bminch/me_gizmo/PCBs/me_gizmo/WB_Breakout/WB_Breakout.csv

Reference | Qty | Value | DNP | Exclude from BOM | Exclude from Board | Footprint | Datasheet
C1,C2,C3,C4 | 4 | 0.1u |  |  |  | Capacitor_SMD:C_0603_1608Metric | ~
J1 | 1 | Conn_01x08_Pin |  |  |  | Connector_PinHeader_2.54mm:PinHeader_1x08_P2.54mm_Vertical | ~
J2 | 1 | Conn_01x05_Pin |  |  |  | Connector_PinHeader_2.54mm:PinHeader_1x05_P2.54mm_Vertical | ~
J4 | 1 | Conn_01x10_Pin |  |  |  | Connector_PinHeader_2.54mm:PinHeader_1x10_P2.54mm_Vertical | ~
R1,R2,R3 | 3 | 10k |  |  |  | Resistor_SMD:R_0603_1608Metric | ~
R19,R20,R21,R22,R35,R36,R37,R38,R39,R40,R41,R42 | 12 | 118 |  |  |  | Resistor_SMD:R_0603_1608Metric | ~
R23,R24,R25,R26,R27,R28,R29,R30,R31,R32,R33,R34 | 12 | 348 |  |  |  | Resistor_SMD:R_0603_1608Metric | ~
U1,U2,U3,U4 | 4 | ADG714 |  |  |  | Package_SO:TSSOP-24_4.4x7.8mm_P0.65mm | https://www.analog.com/media/en/technical-documentation/data-sheets/ADG714_715.pdf
