bminch/me_gizmo/PCBs/Eclectronics/3dshapes/plug-usbc-241smtv-4bs60_asm.stp

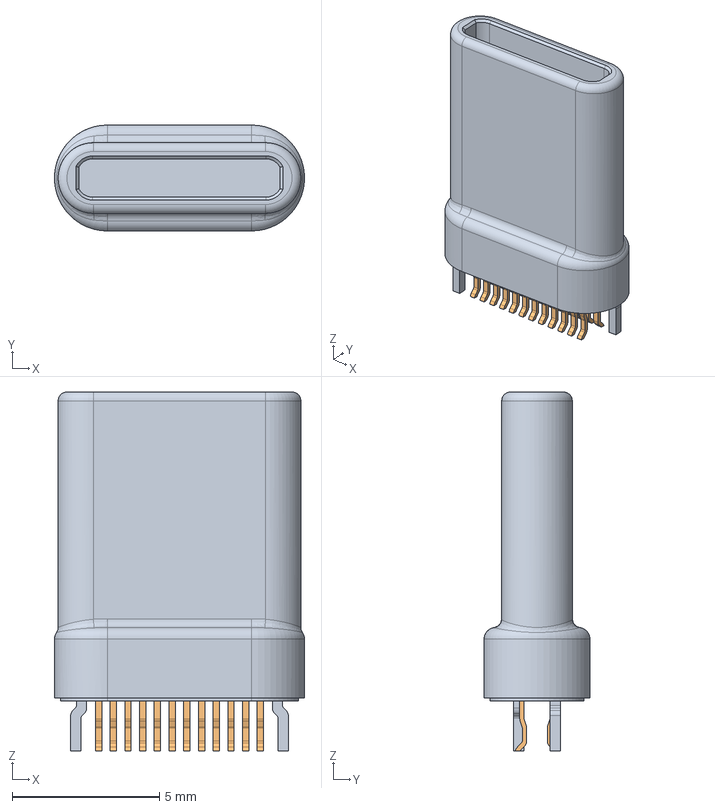
[picture p1: CAD file, 2026-06-01]
PCBs/Eclectronics/3dshapes/plug-usbc-241smtv-4bs60_asm.stp
8.50 x 3.60 x 12.2 mm
PLUG-USBC-241SMTV-4BS60_1
PLUG-USBC-241SMTV-4BS60_2
PLUG-USBC-241SMTV-4BS60_3
PLUG-USBC-241SMTV-4BS60_4
PLUG-USBC-241SMTV-4BS60_5
PLUG-USBC-241SMTV-4BS60_6
PLUG-USBC-241SMTV-4BS60_7
PLUG-USBC-241SMTV-4BS60_8
PLUG-USBC-241SMTV-4BS60_9
PLUG-USBC-241SMTV-4BS60_10
PLUG-USBC-241SMTV-4BS60_11
PLUG-USBC-241SMTV-4BS60_12
PLUG-USBC-241SMTV-4BS60_13
PLUG-USBC-241SMTV-4BS60_14
PLUG-USBC-241SMTV-4BS60_15
PLUG-USBC-241SMTV-4BS60_16
PLUG-USBC-241SMTV-4BS60_17
PLUG-USBC-241SMTV-4BS60_18
PLUG-USBC-241SMTV-4BS60_19
PLUG-USBC-241SMTV-4BS60_20
PLUG-USBC-241SMTV-4BS60_21
PLUG-USBC-241SMTV-4BS60_22
PLUG-USBC-241SMTV-4BS60_23
PLUG-USBC-241SMTV-4BS60_24
PLUG-USBC-241SMTV-4BS60_25
