bminch/me_gizmo/PCBs/Eclectronics/3dshapes/RP2350B.step

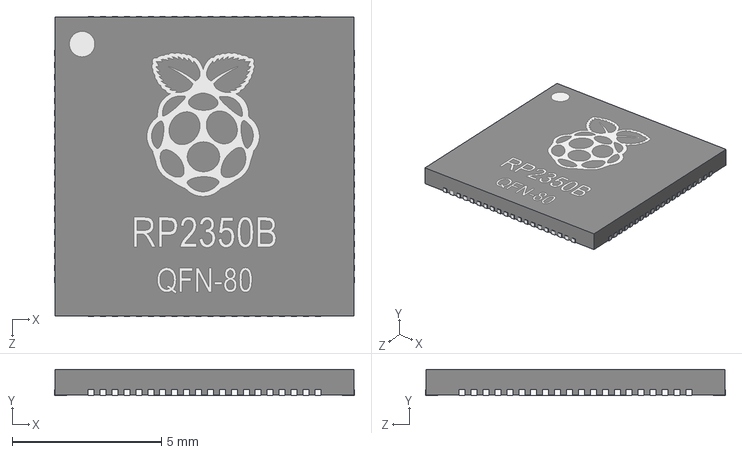
[picture p2: CAD file, 2026-06-11]
PCBs/Eclectronics/3dshapes/RP2350B.step
10.1 x 0.875 x 10.1 mm
