bminch/me_gizmo/PCBs/Eclectronics/3dshapes/DFN1006-2.stp

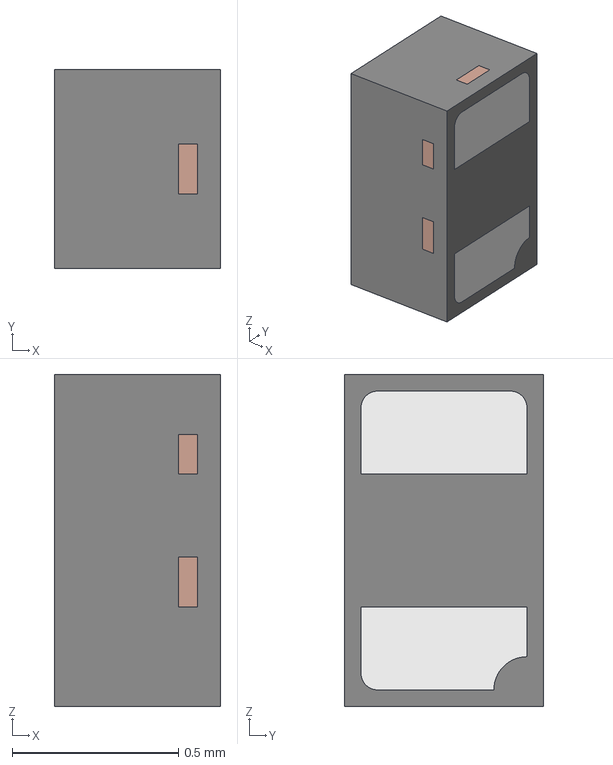
[picture p3: CAD file, 2026-06-01]
PCBs/Eclectronics/3dshapes/DFN1006-2.stp
0.5 x 0.6 x 1.00 mm
LDF
