bminch/me_gizmo/PCBs/Eclectronics/3dshapes/USB4505-03-0-A_REVA.step

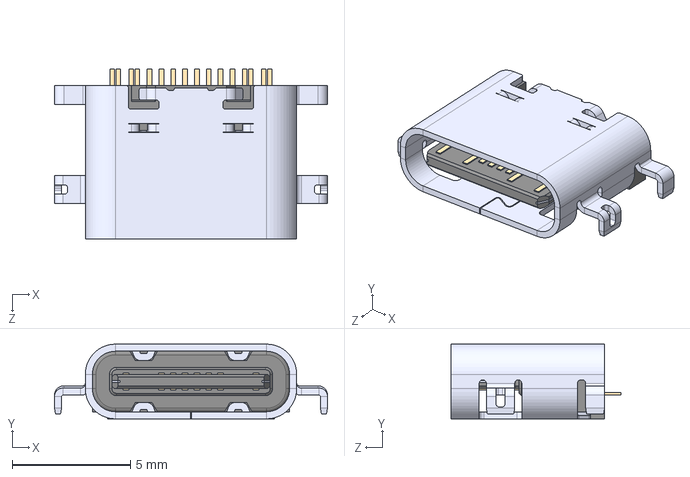
[picture p4: CAD file, 2026-06-01]
PCBs/Eclectronics/3dshapes/USB4505-03-0-A_REVA.step
11.5 x 3.16 x 7.20 mm
