bminch/me_gizmo/PCBs/Eclectronics/3dshapes/WSON8-6x5.STEP

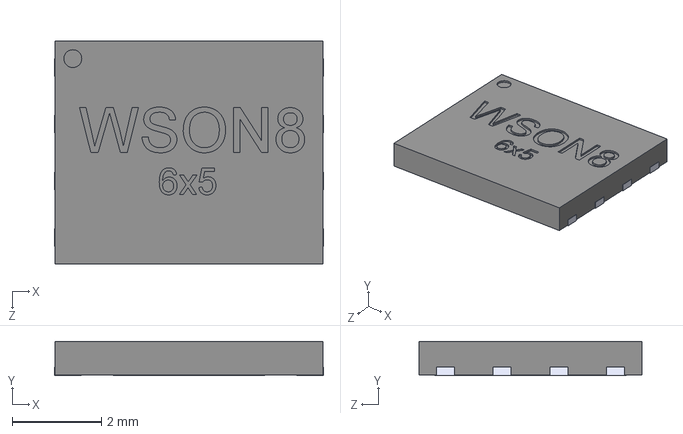
[picture p5: CAD file, 2026-06-01]
PCBs/Eclectronics/3dshapes/WSON8-6x5.STEP
6.02 x 0.77 x 5.00 mm
