bminch/me_gizmo/PCBs/Eclectronics/3dshapes/S4B-PH-SM4-TB.stp

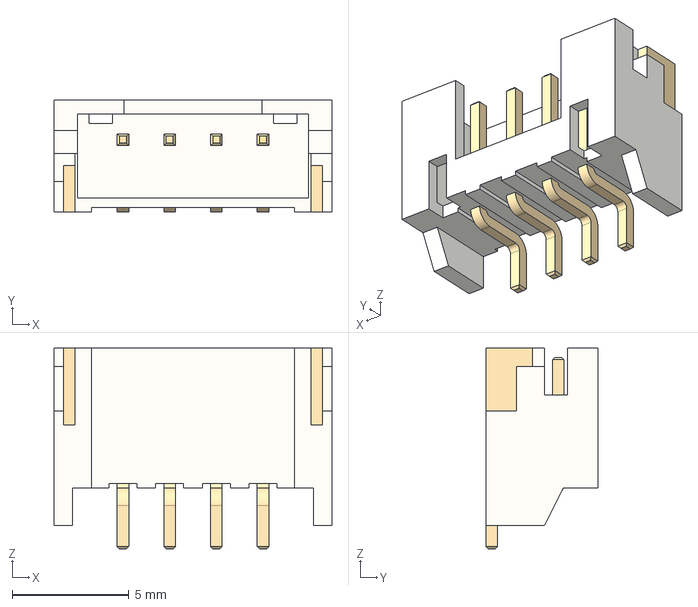
[picture p6: CAD file, 2026-06-01]
PCBs/Eclectronics/3dshapes/S4B-PH-SM4-TB.stp
11.9 x 4.80 x 8.60 mm
