bminch/me_gizmo/PCBs/Eclectronics/3dshapes/CUI_DEVICES_PJ-202A.step

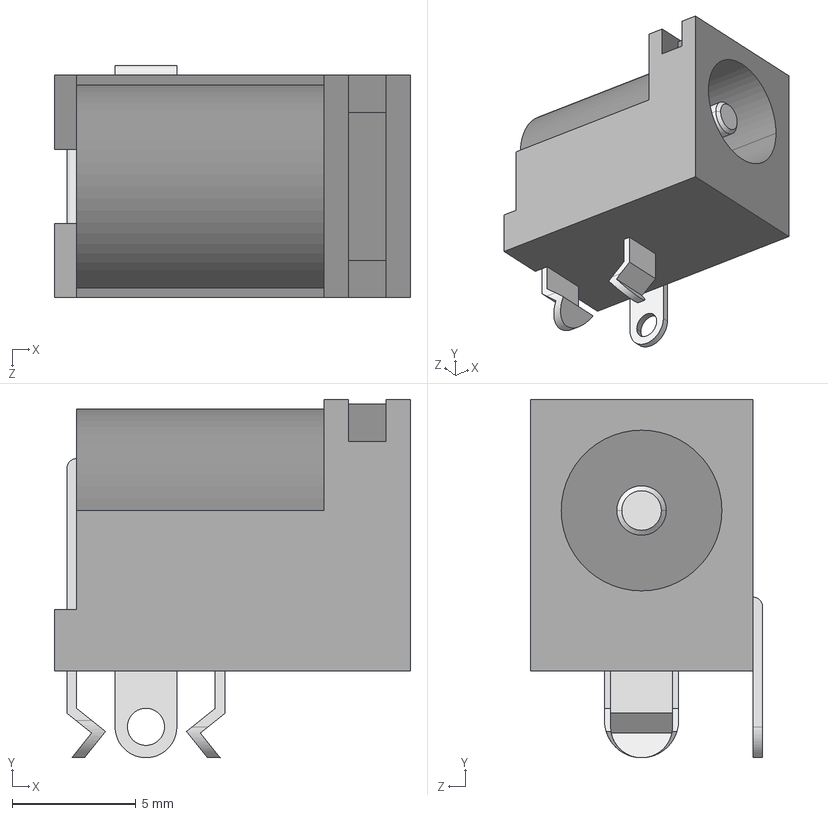
[picture p7: CAD file, 2026-06-01]
PCBs/Eclectronics/3dshapes/CUI_DEVICES_PJ-202A.step
14.4 x 14.5 x 9.40 mm
