bminch/me_gizmo/PCBs/Eclectronics/3dshapes/BarrelJack.STEP

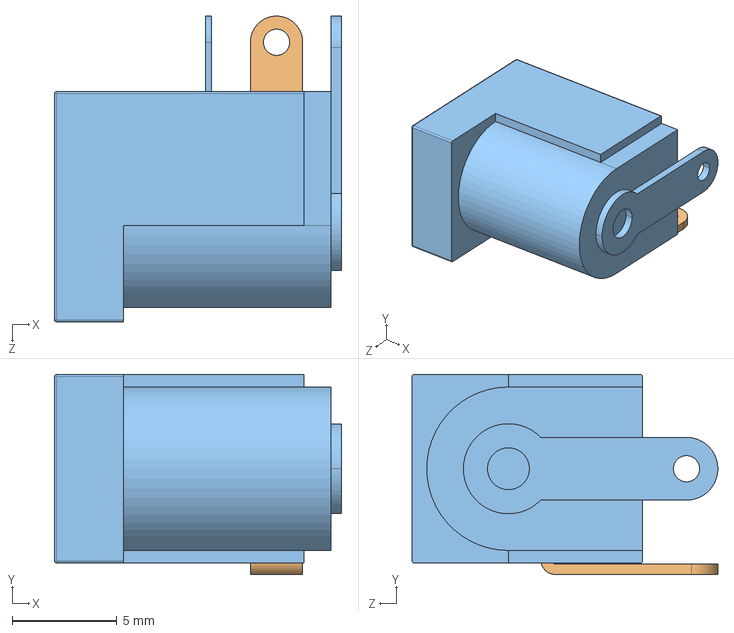
[picture p8: CAD file, 2026-06-01]
PCBs/Eclectronics/3dshapes/BarrelJack.STEP
13.7 x 9.55 x 14.6 mm
