bminch/me_gizmo/PCBs/Eclectronics/3dshapes/TL3301NFxxxxJ.stp

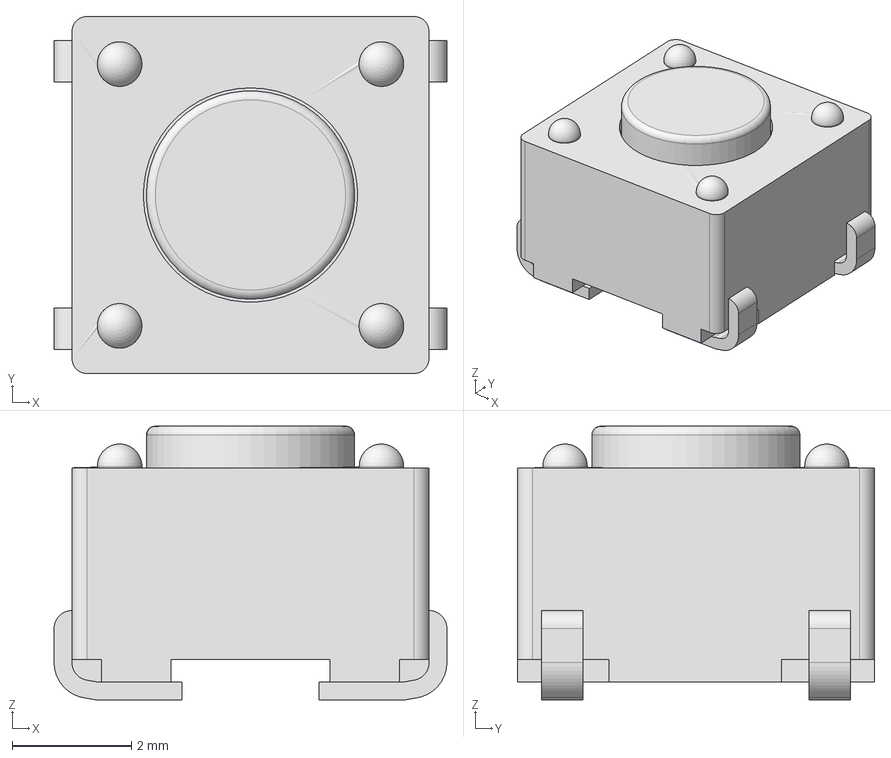
[picture p10: CAD file, 2026-06-01]
PCBs/Eclectronics/3dshapes/TL3301NFxxxxJ.stp
6.60 x 6.00 x 4.60 mm
