bminch/me_gizmo/PCBs/Eclectronics/3dshapes/ABS06-107.STP

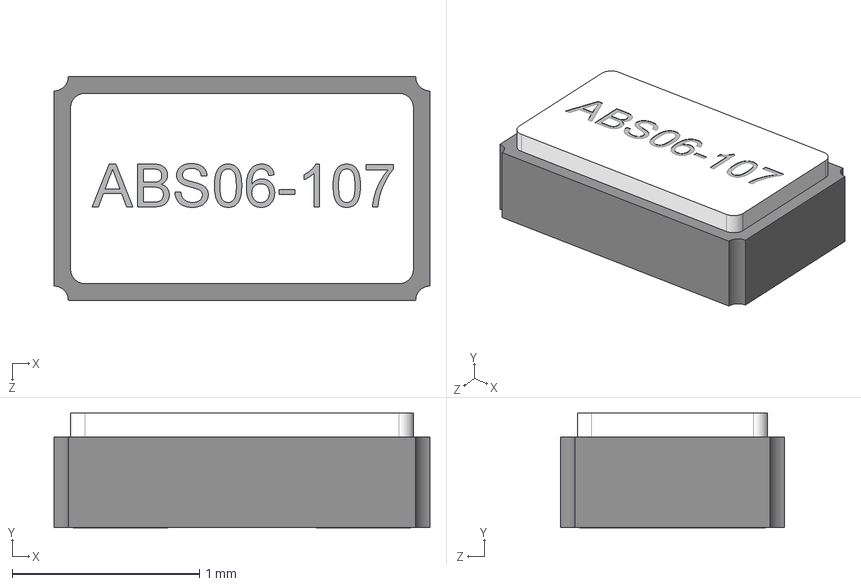
[picture p11: CAD file, 2026-06-01]
PCBs/Eclectronics/3dshapes/ABS06-107.STP
2.01 x 0.612 x 1.19 mm
