bminch/me_gizmo/PCBs/Eclectronics/3dshapes/ABM10.STP

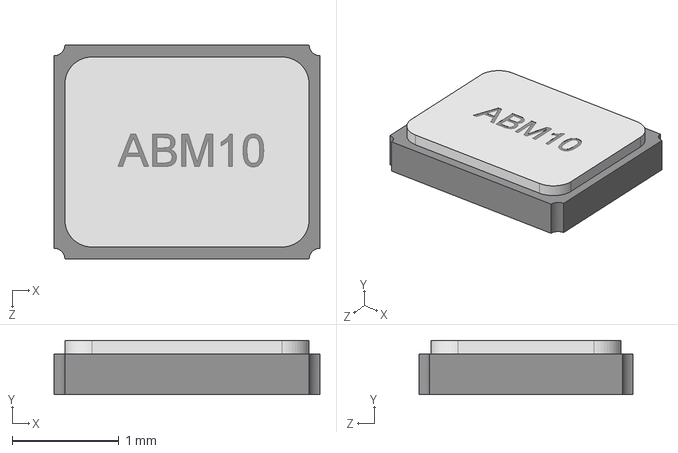
[picture p12: CAD file, 2026-06-01]
PCBs/Eclectronics/3dshapes/ABM10.STP
2.49 x 0.508 x 2.01 mm
