bminch/me_gizmo/PCBs/Eclectronics/3dshapes/WS2812-2020.STEP

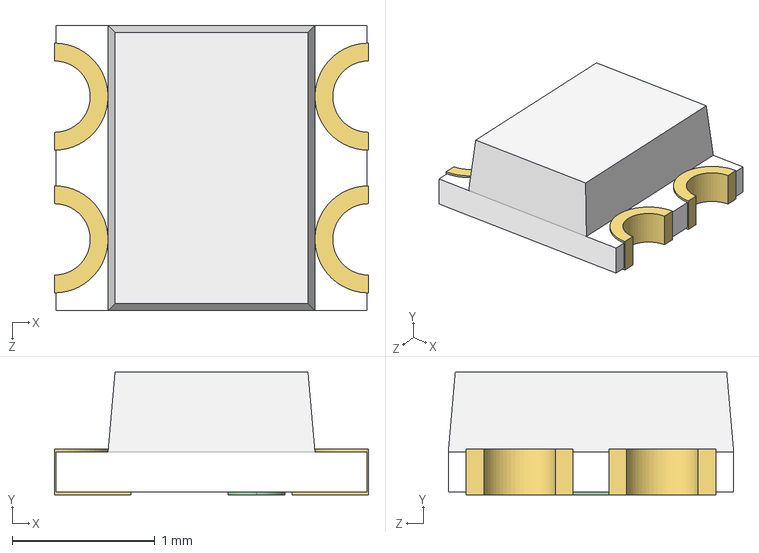
[picture p13: CAD file, 2026-06-01]
PCBs/Eclectronics/3dshapes/WS2812-2020.STEP
2.20 x 0.86 x 2.00 mm
