bminch/me_gizmo/PCBs/Eclectronics/3dshapes/ABM10-27.000MHZ-E20-T.step

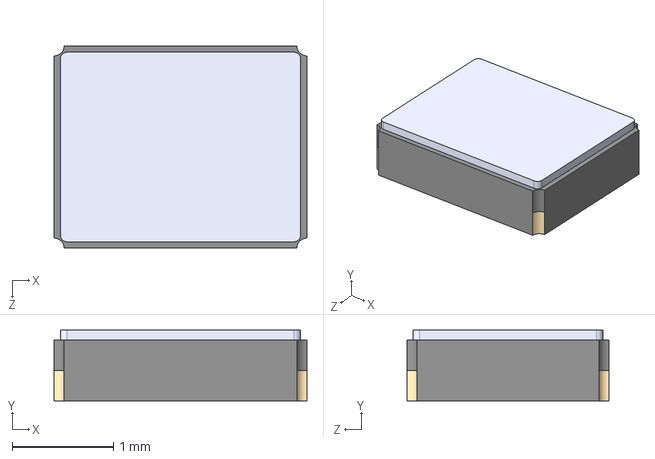
[picture p14: CAD file, 2026-06-01]
PCBs/Eclectronics/3dshapes/ABM10-27.000MHZ-E20-T.step
2.50 x 0.7 x 2.00 mm
