bminch/me_gizmo/PCBs/Eclectronics/3dshapes/B4B-XH-A.step

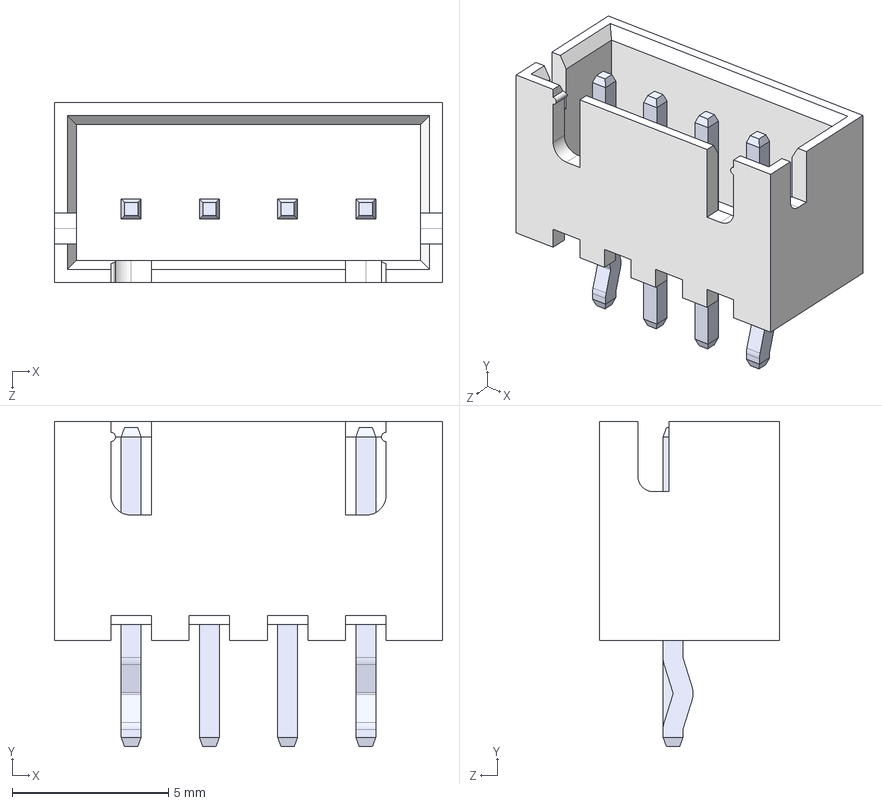
[picture p15: CAD file, 2026-06-01]
PCBs/Eclectronics/3dshapes/B4B-XH-A.step
12.4 x 10.4 x 5.75 mm
