bminch/me_gizmo/PCBs/Eclectronics/3dshapes/IN-S85TATRGB.stp

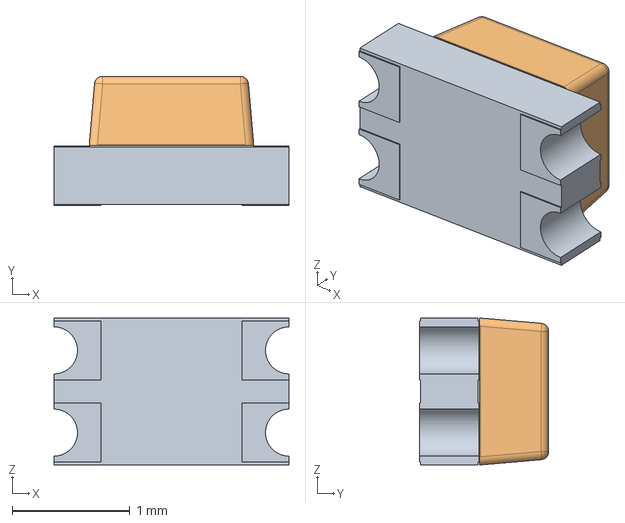
[picture p16: CAD file, 2026-06-01]
PCBs/Eclectronics/3dshapes/IN-S85TATRGB.stp
2.00 x 1.10 x 1.25 mm
