bminch/me_gizmo/PCBs/Eclectronics/3dshapes/3382g-001-xxx.stp

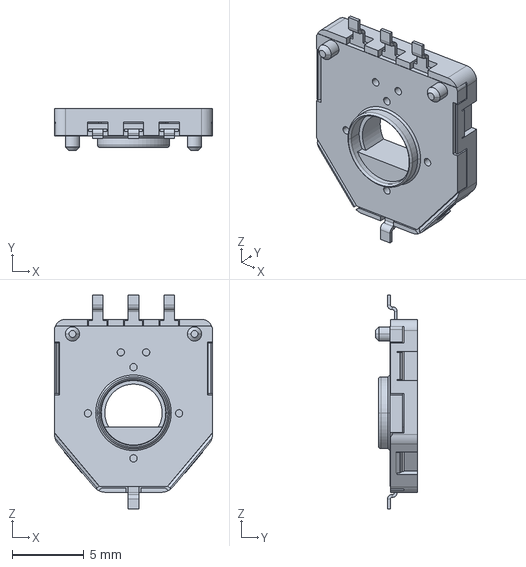
[picture p17: CAD file, 2026-06-01]
PCBs/Eclectronics/3dshapes/3382g-001-xxx.stp
11.0 x 2.95 x 14.9 mm
