bminch/me_gizmo/PCBs/Eclectronics/3dshapes/CUI_SDS-50J.step

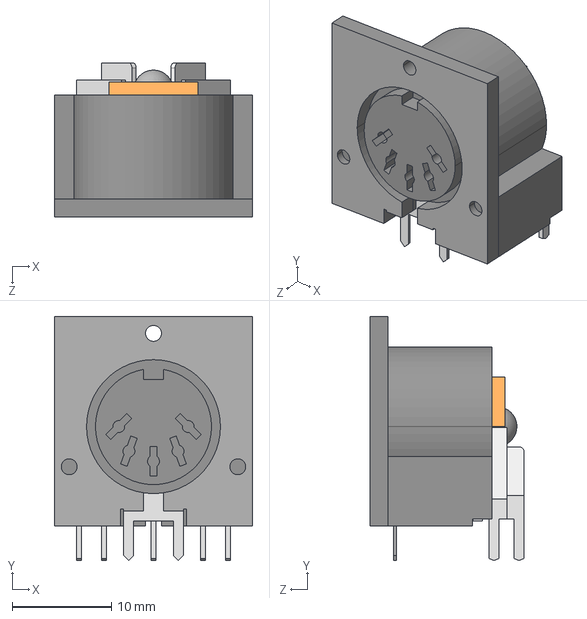
[picture p18: CAD file, 2026-06-01]
PCBs/Eclectronics/3dshapes/CUI_SDS-50J.step
20.0 x 24.6 x 15.5 mm
