bminch/me_gizmo/PCBs/Eclectronics/3dshapes/RP2350A-QFN60.step

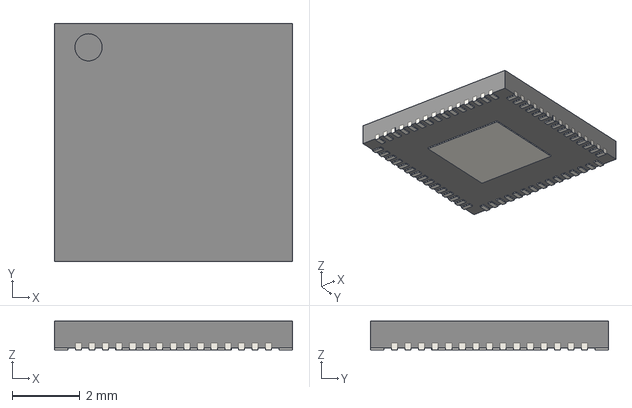
[picture p19: CAD file, 2026-06-01]
PCBs/Eclectronics/3dshapes/RP2350A-QFN60.step
7.00 x 7.00 x 0.85 mm
