bminch/me_gizmo/PCBs/Eclectronics/3dshapes/219-3M.STEP

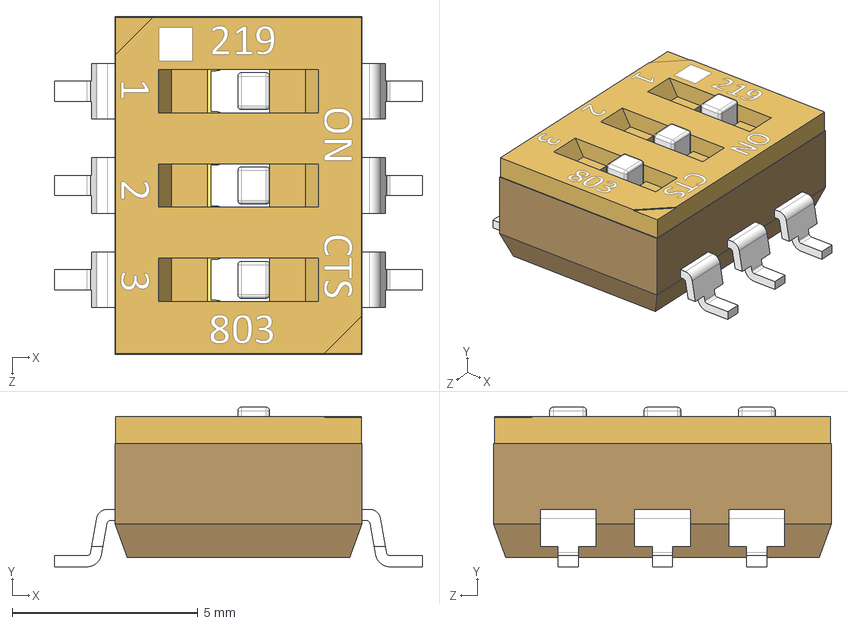
[picture p20: CAD file, 2026-06-01]
PCBs/Eclectronics/3dshapes/219-3M.STEP
9.91 x 4.30 x 9.10 mm
