bminch/me_gizmo/PCBs/Eclectronics/3dshapes/usb4216-03-a.stp

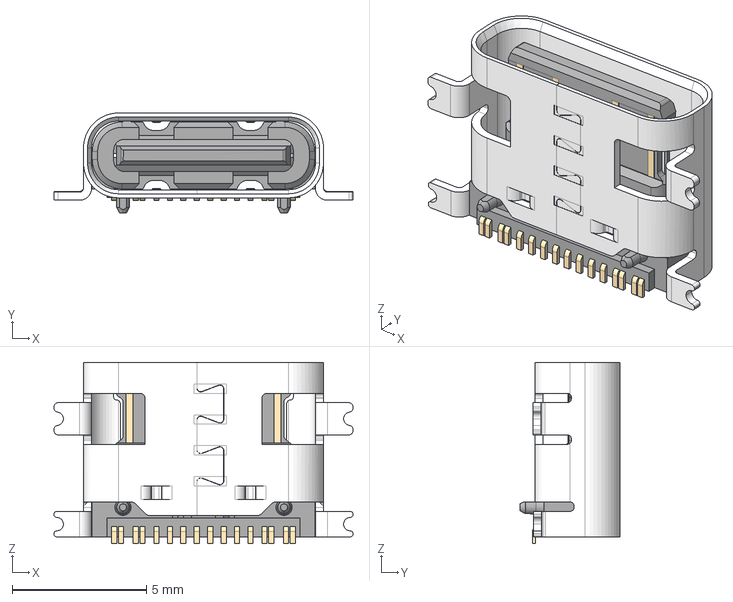
[picture p21: CAD file, 2026-06-01]
PCBs/Eclectronics/3dshapes/usb4216-03-a.stp
11.1 x 3.73 x 6.75 mm
