bminch/me_gizmo/PCBs/Eclectronics/3dshapes/RTE0020A.stp

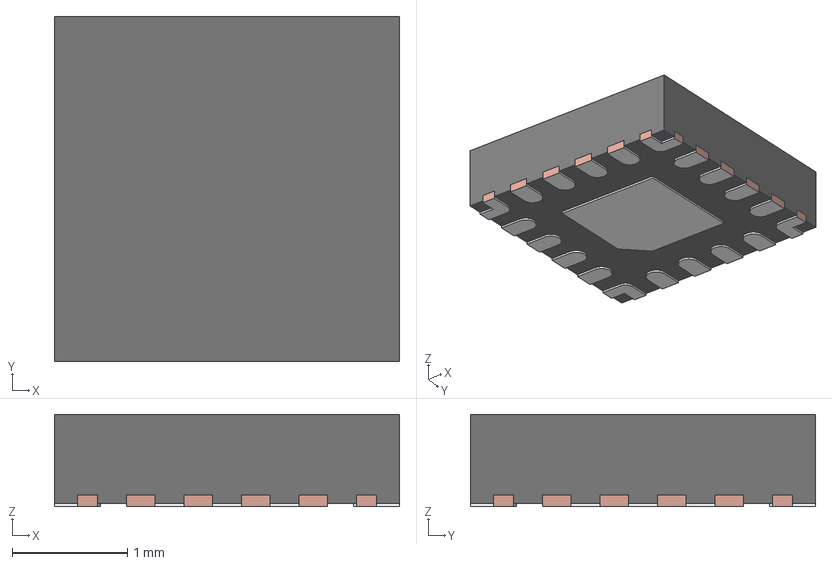
[picture p22: CAD file, 2026-06-01]
PCBs/Eclectronics/3dshapes/RTE0020A.stp
3.00 x 3.00 x 0.8 mm
FRAME
