bminch/me_gizmo/PCBs/Eclectronics/3dshapes/CSTNE.step

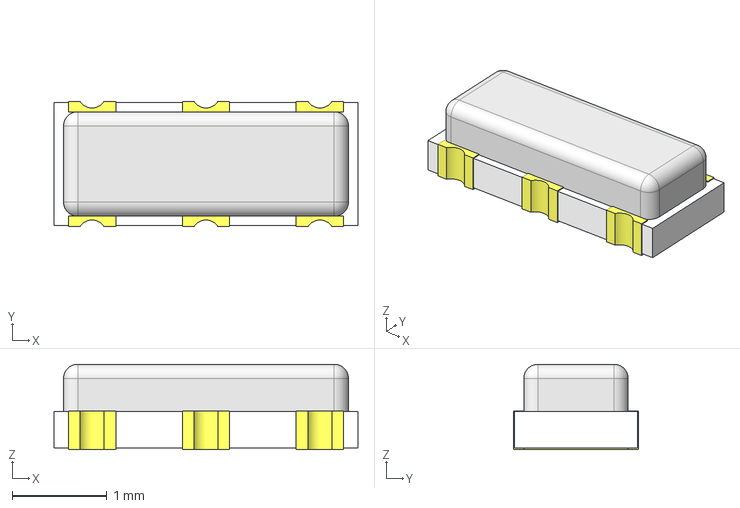
[picture p23: CAD file, 2026-06-01]
PCBs/Eclectronics/3dshapes/CSTNE.step
3.20 x 1.32 x 0.9 mm
