bminch/me_gizmo/PCBs/Eclectronics/3dshapes/WS2812_RGB_LED_updated.stp

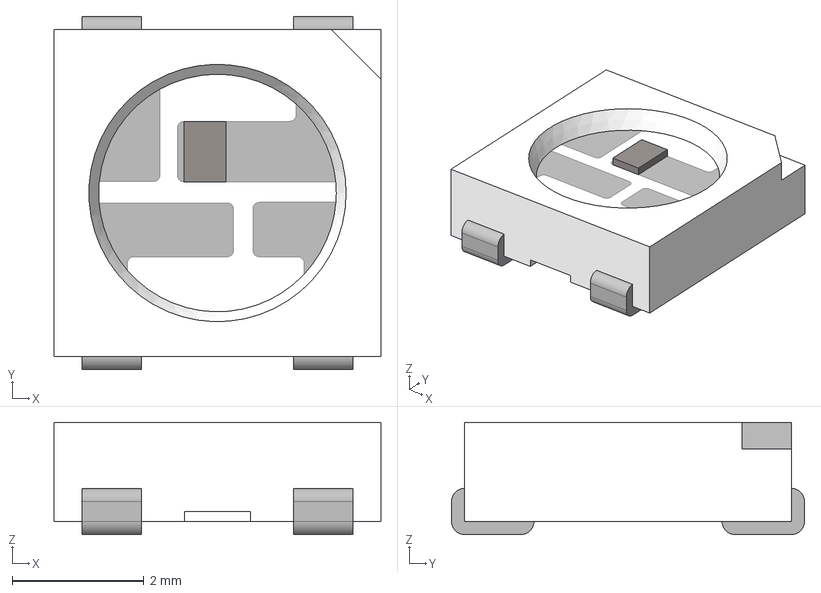
[picture p24: CAD file, 2026-06-01]
PCBs/Eclectronics/3dshapes/WS2812_RGB_LED_updated.stp
4.95 x 5.35 x 1.70 mm
