bminch/me_gizmo/PCBs/Eclectronics/3dshapes/SJ-3524-SMT-TR-BE.step

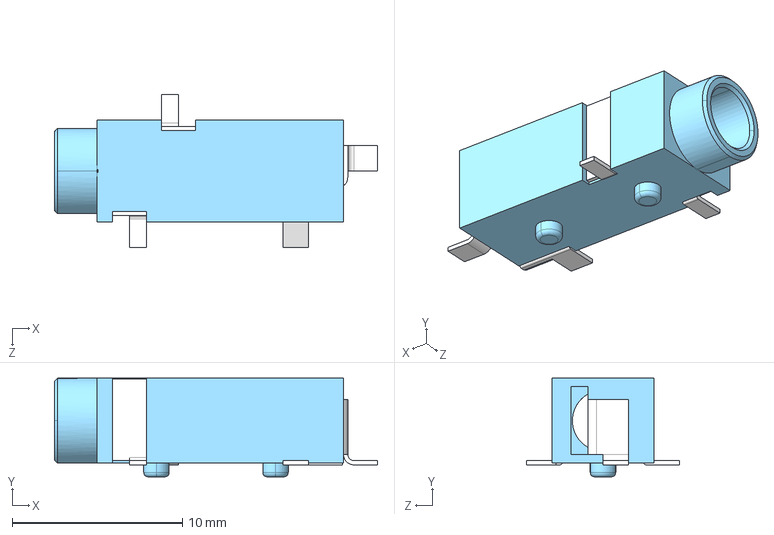
[picture p25: CAD file, 2026-06-01]
PCBs/Eclectronics/3dshapes/SJ-3524-SMT-TR-BE.step
19.0 x 5.80 x 9.00 mm
