bminch/me_gizmo/PCBs/Eclectronics/3dshapes/UFQFPN48.stp

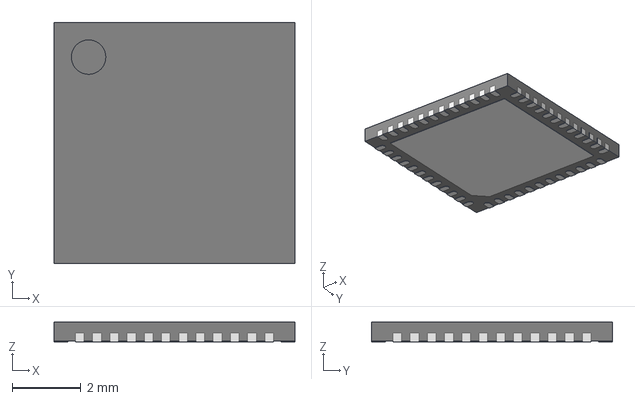
[picture p26: CAD file, 2026-06-01]
PCBs/Eclectronics/3dshapes/UFQFPN48.stp
7.00 x 7.00 x 0.57 mm
