bminch/me_gizmo/PCBs/Eclectronics/3dshapes/PA5003.182NLT.step

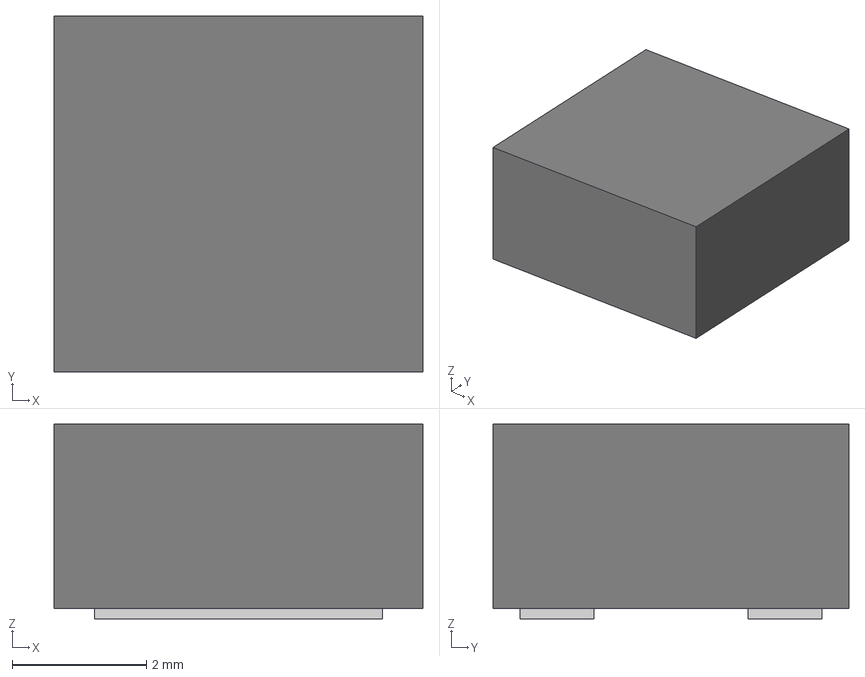
[picture p27: CAD file, 2026-06-01]
PCBs/Eclectronics/3dshapes/PA5003.182NLT.step
5.50 x 5.30 x 2.90 mm
