bminch/me_gizmo/PCBs/Eclectronics/3dshapes/STP_831056289_rev1.stp

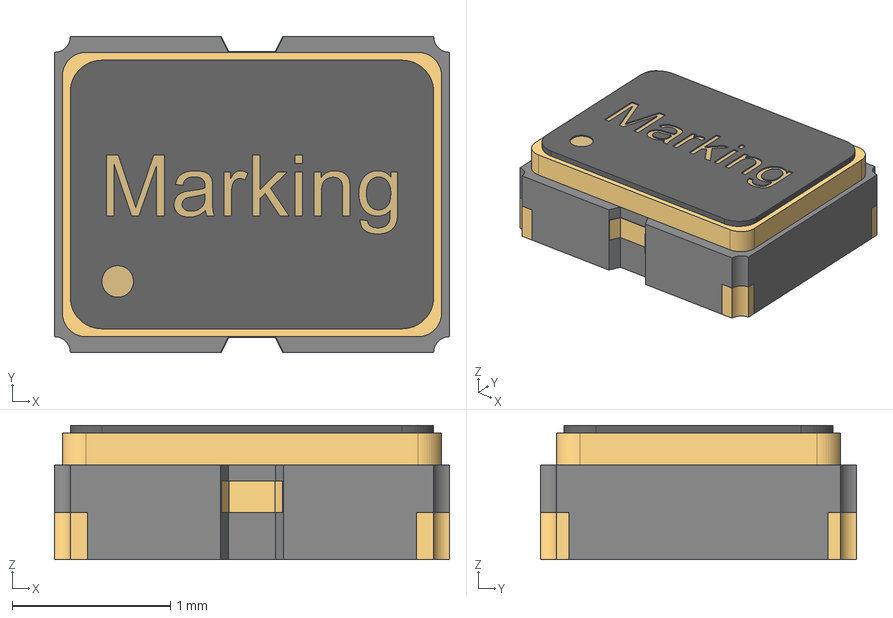
[picture p28: CAD file, 2026-06-01]
PCBs/Eclectronics/3dshapes/STP_831056289_rev1.stp
2.50 x 2.00 x 0.85 mm
Pins
Cover
