bminch/me_gizmo/PCBs/Eclectronics/3dshapes/USB4105-GF-A.step

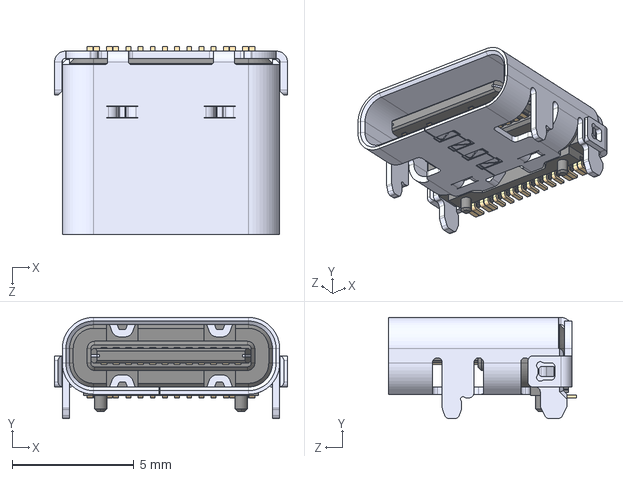
[picture p29: CAD file, 2026-06-01]
PCBs/Eclectronics/3dshapes/USB4105-GF-A.step
9.58 x 4.16 x 7.71 mm
