bminch/me_gizmo/PCBs/Eclectronics/3dshapes/DFN8_3x3_0.65.step

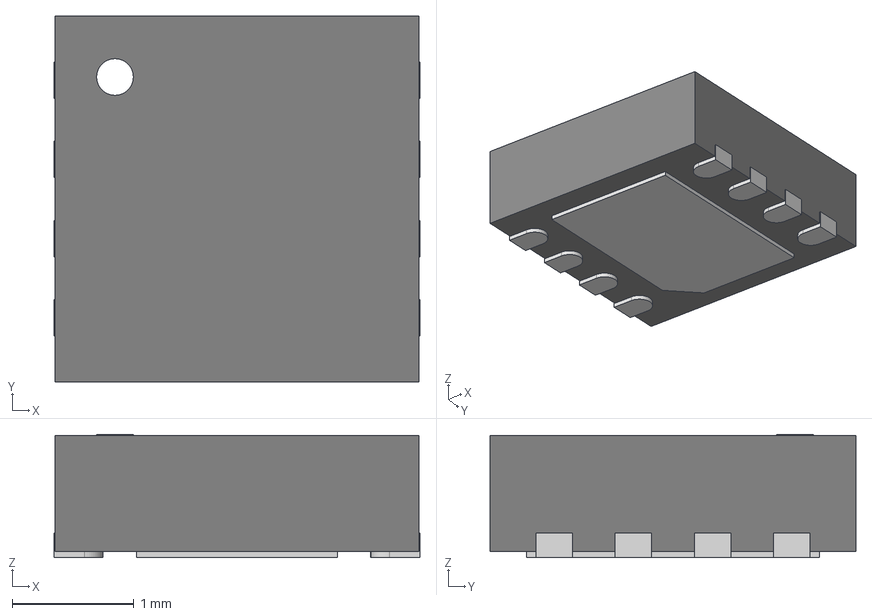
[picture p30: CAD file, 2026-06-01]
PCBs/Eclectronics/3dshapes/DFN8_3x3_0.65.step
3.00 x 3.00 x 1.01 mm
