bminch/me_gizmo/PCBs/Eclectronics/3dshapes/Analog_Devices_Inc_-_ADXL362BCCZ.step

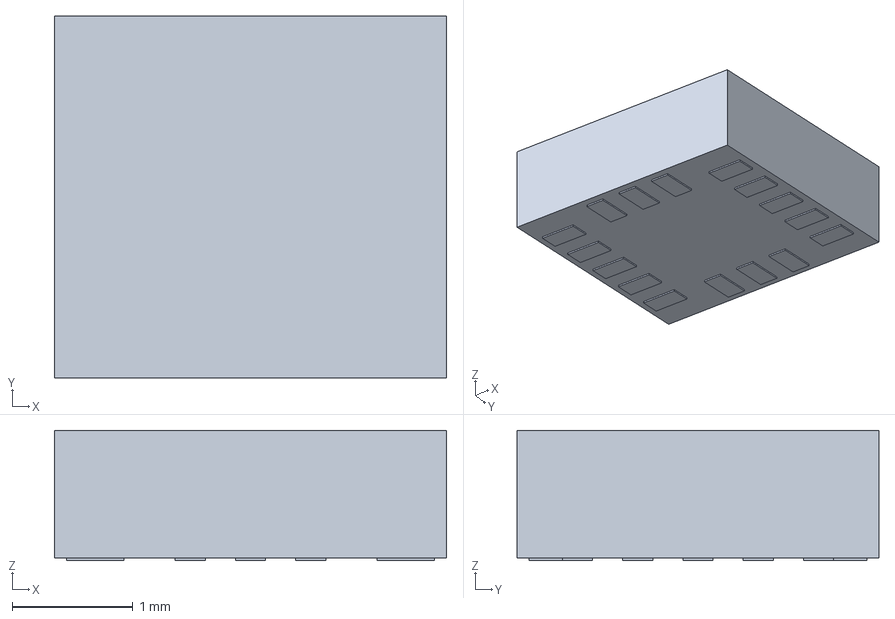
[picture p33: CAD file, 2026-06-01]
PCBs/Eclectronics/3dshapes/Analog_Devices_Inc_-_ADXL362BCCZ.step
3.25 x 3.00 x 1.08 mm
