bminch/me_gizmo/PCBs/Eclectronics/3dshapes/TL3301AFxxxxJ.stp

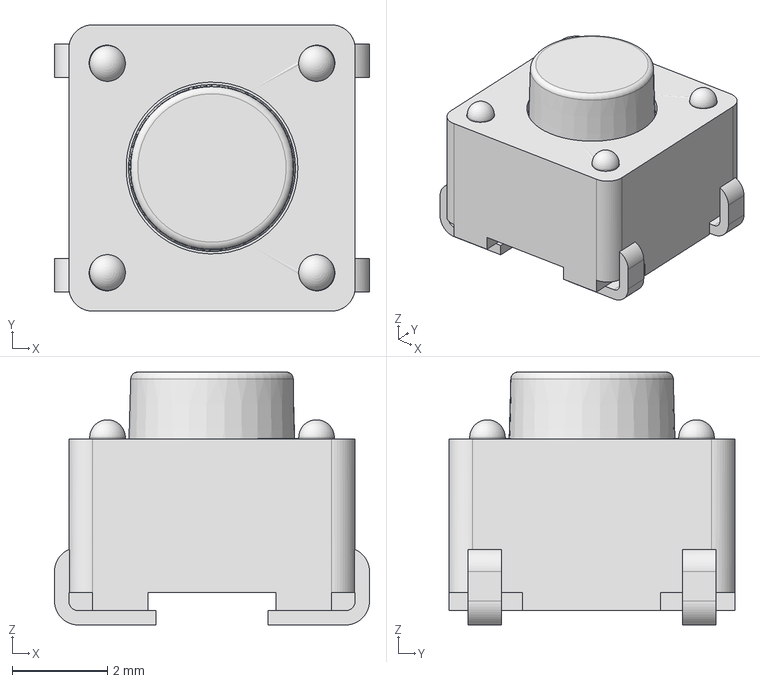
[picture p34: CAD file, 2026-06-01]
PCBs/Eclectronics/3dshapes/TL3301AFxxxxJ.stp
6.60 x 6.00 x 5.30 mm
