bminch/me_gizmo/PCBs/Eclectronics/3dshapes/KXT321LHS.stp

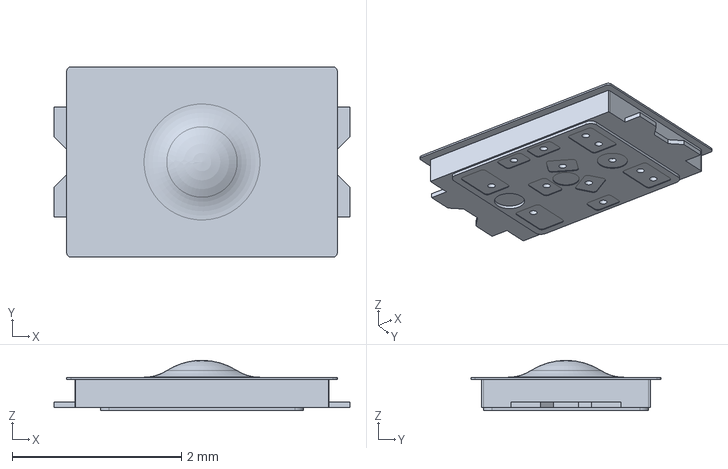
[picture p35: CAD file, 2026-06-01]
PCBs/Eclectronics/3dshapes/KXT321LHS.stp
3.50 x 2.25 x 0.595 mm
