bminch/me_gizmo/PCBs/Eclectronics/3dshapes/EEEFTH101XAL.step

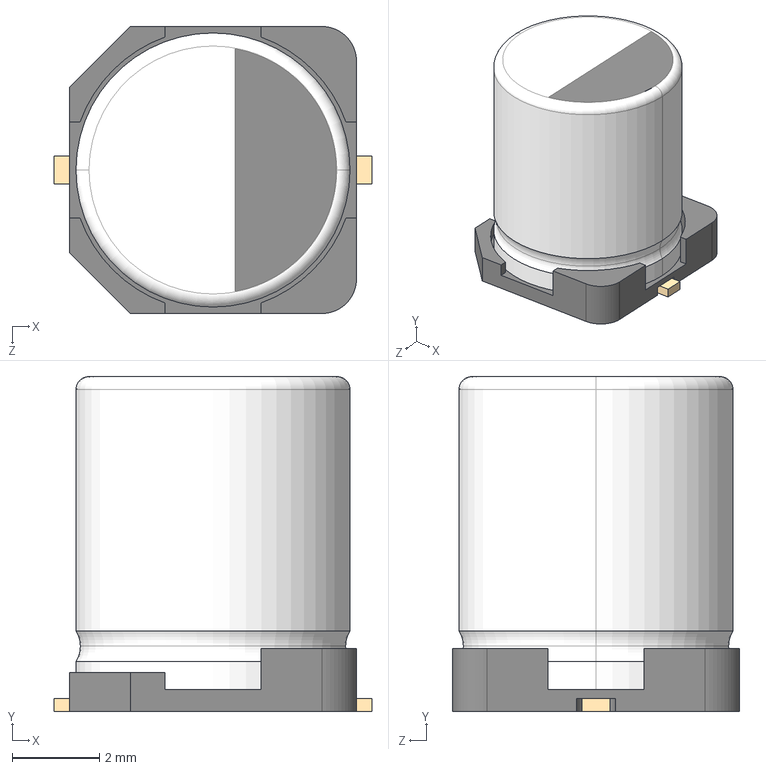
[picture p36: CAD file, 2026-06-01]
PCBs/Eclectronics/3dshapes/EEEFTH101XAL.step
7.30 x 7.70 x 6.60 mm
