bminch/me_gizmo/PCBs/Eclectronics/3dshapes/AOTA-B201610S3R3-101-T.stp

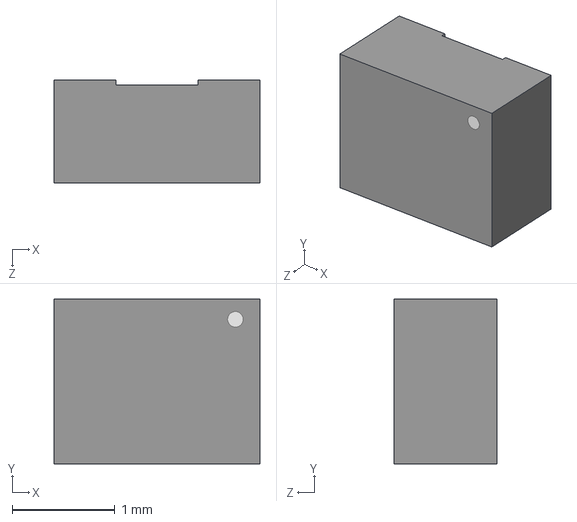
[picture p37: CAD file, 2026-06-01]
PCBs/Eclectronics/3dshapes/AOTA-B201610S3R3-101-T.stp
2.00 x 1.60 x 1.00 mm
