bminch/me_gizmo/PCBs/Eclectronics/3dshapes/RP2040_QFN_PACKAGE.STEP

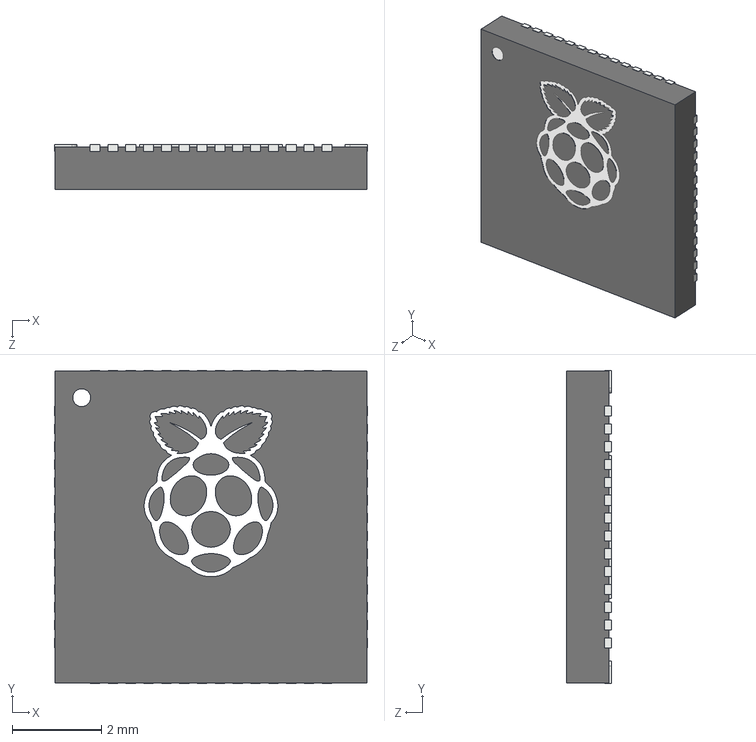
[picture p38: CAD file, 2026-06-01]
PCBs/Eclectronics/3dshapes/RP2040_QFN_PACKAGE.STEP
7.02 x 7.02 x 1.00 mm
