bminch/me_gizmo/PCBs/Eclectronics/3dshapes/QFN-32_5x5.stp

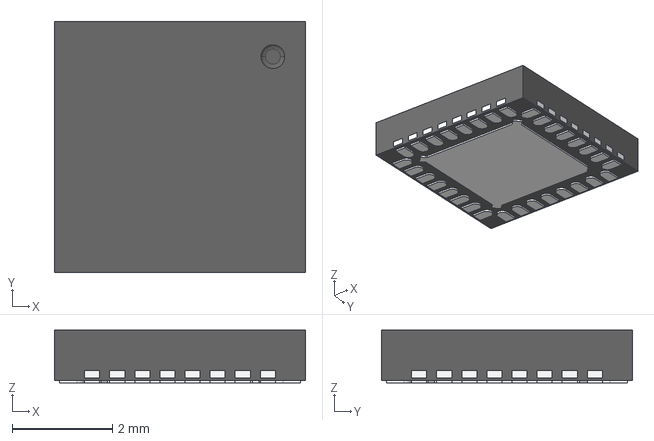
[picture p39: CAD file, 2026-06-01]
PCBs/Eclectronics/3dshapes/QFN-32_5x5.stp
5.00 x 5.00 x 1.05 mm
