bminch/me_gizmo/(list of files, cad)

Other CAD files:
PCBs/me_gizmo/PCB_cover-me_gizmo.dwg
PCBs/Eclectronics/3dshapes/RP2354B.step
PCBs/Eclectronics/3dshapes/1725656.stp
PCBs/Eclectronics/3dshapes/397000006.stp
PCBs/Eclectronics/3dshapes/5442565.stp
