bminch/me_gizmo/PCBs/me_gizmo/me_gizmo.kicad_pcb

## KiCad design PCBs/me_gizmo/me_gizmo.kicad_pcb (2026-08-10)

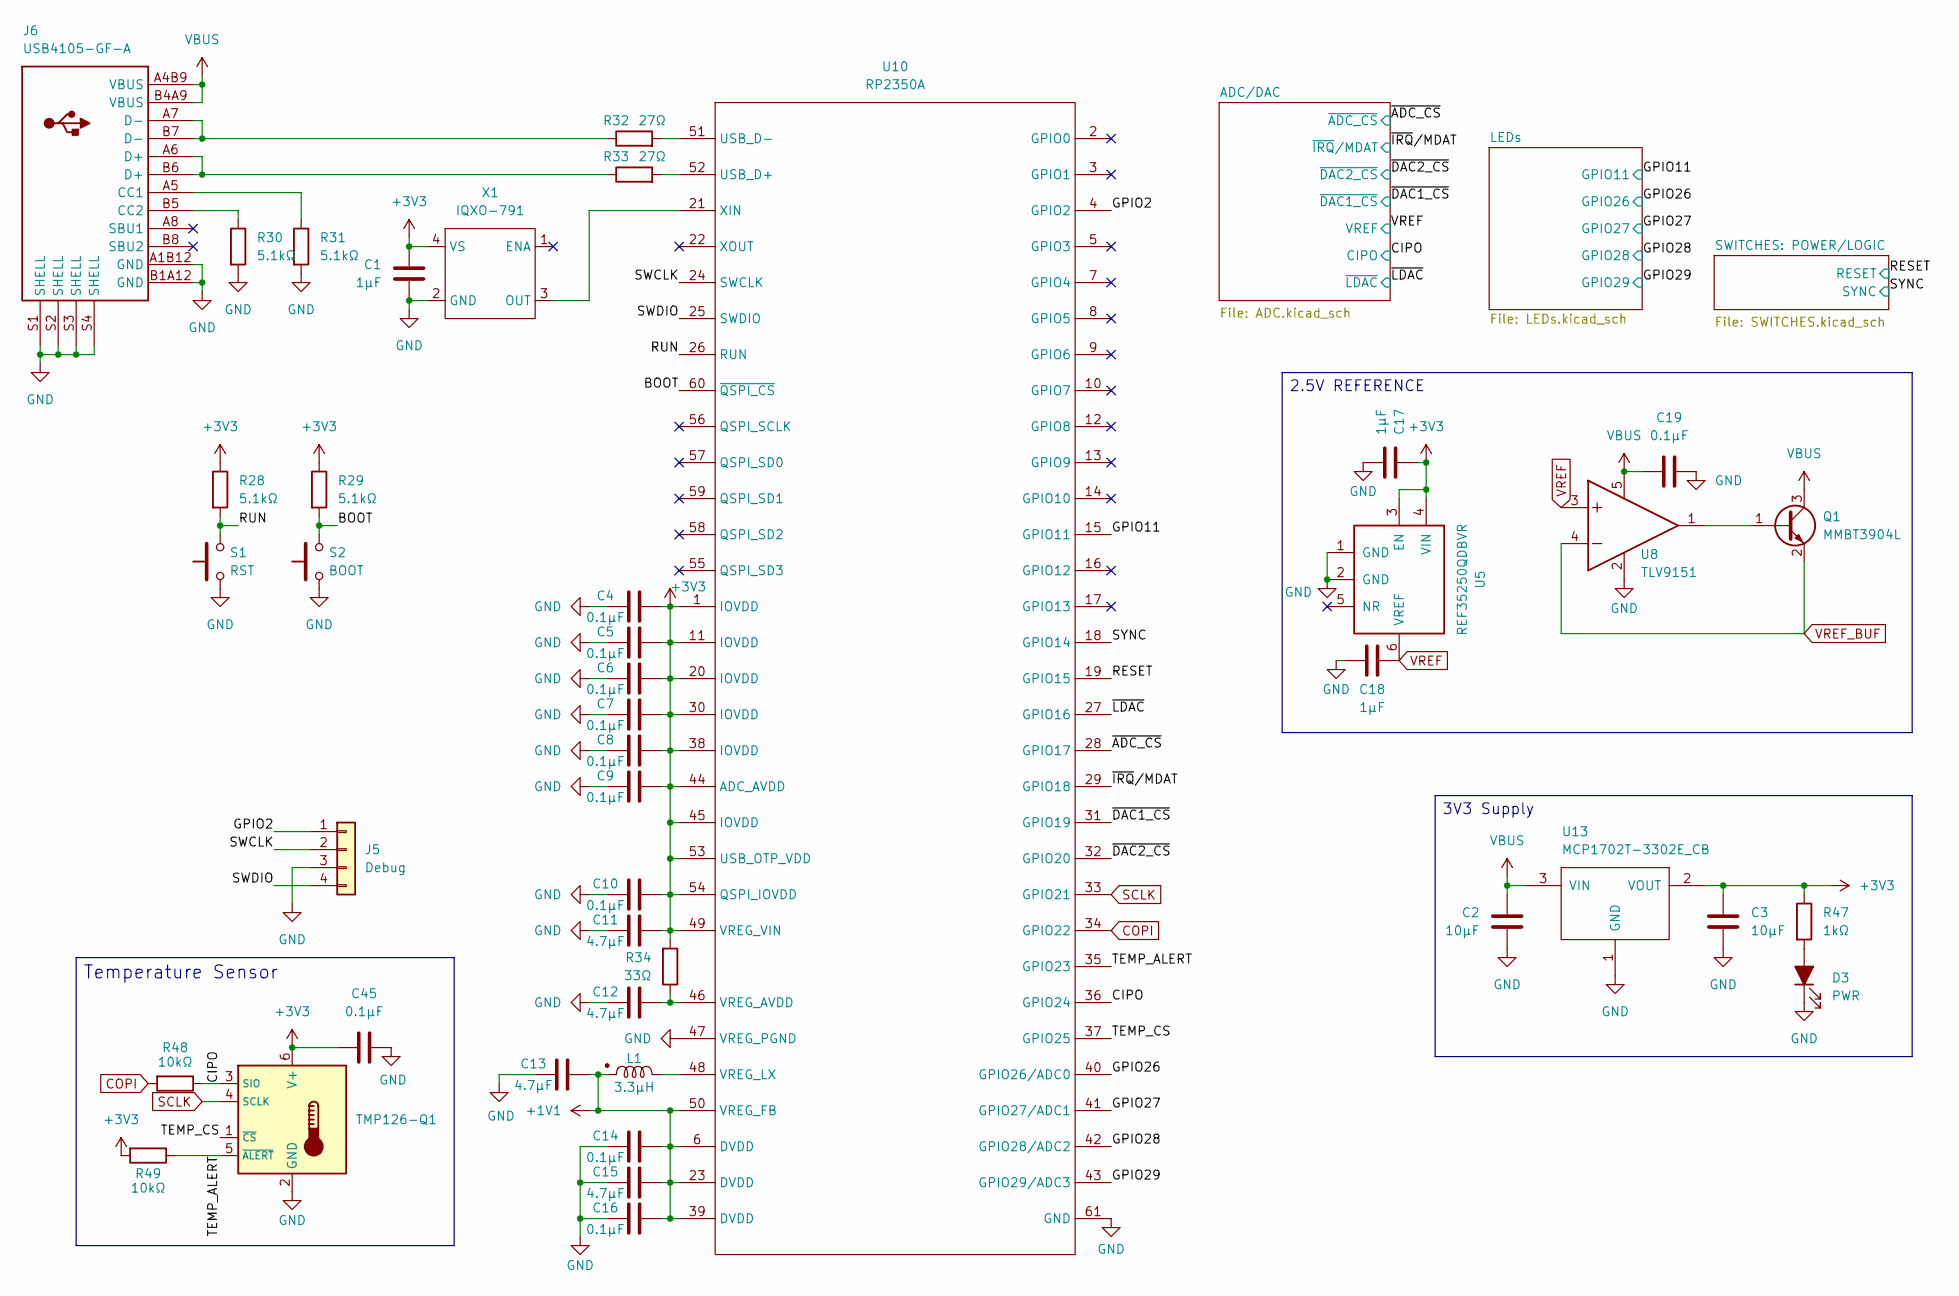
[picture p40: schematic me_gizmo.kicad_sch]

Parts:
C1: 1µF; C_0402_1005Metric
C2, C3: 10µF; C_0603_1608Metric
C4, C5, C6, C7, C8, C9, C10, C14, C16: 0.1µF; C_0402_1005Metric
C11, C12, C13, C15: 4.7µF; C_0402_1005Metric
C17, C18: 1µF; C_0603_1608Metric
C19, C45: 0.1µF; C_0603_1608Metric
D3: PWR; LED_0805_2012Metric
J5: Debug; PinHeader_1x04_P2.54mm_Vertical
J6: USB4105-GF-A
L1: 3.3µH; AOTA-B201610S3R3-101-T
Q1: MMBT3904L; SOT-23
R28, R29, R30, R31: 5.1kΩ; R_0603_1608Metric
R32, R33: 27Ω; R_0402_1005Metric
R34: 33Ω; R_0402_1005Metric
R47: 1kΩ; R_0603_1608Metric
R48, R49: 10kΩ; R_0603_1608Metric
S1: RST; SW_SPST_B3U-1000P
S2: BOOT; SW_SPST_B3U-1000P
U5: REF35250QDBVR; SOT-23-6
U6: TMP126-Q1; SOT-23-6
U8: TLV9151; SOT-23-5
U10: RP2350A; RP2350A_QFN-60_EP_7.75x7.75_Pitch0.4mm
U13: MCP1702T-3302E_CB; SOT-23
X1: IQXO-791

Connections:
+1V1: C13.2, C14.2, C15.2, C16.2, L1.1, U10.6 (DVDD), U10.23 (DVDD), U10.39 (DVDD), U10.50 (VREG_FB)
+3V3: C1.2, C3.1, C4.2, C5.2, C6.2, C7.2, C8.2, C9.2, C10.2, C11.2, C17.1, C45.1, R28.1, R29.1, R34.2, R47.1, R49.2, U5.3 (EN), U5.4 (VIN), U6.6 (V+), U10.1 (IOVDD), U10.11 (IOVDD), U10.20 (IOVDD), U10.30 (IOVDD), U10.38 (IOVDD), U10.44 (ADC_AVDD), U10.45 (IOVDD), U10.49 (VREG_VIN), U10.53 (USB_OTP_VDD), U10.54 (QSPI_IOVDD), U13.2 (VOUT), X1.4 (VS); also elsewhere on the board
/BOOT: R29.2, S2.2, U10.60 (~QSPI_CS)
/CIPO: R48.1, U6.3 (SIO), U10.36 (GPIO24); also elsewhere on the board
/GPIO2: J5.1, U10.4 (GPIO2)
/GPIO11: U10.15 (GPIO11); also elsewhere on the board
/GPIO26: U10.40 (GPIO26/ADC0); also elsewhere on the board
/GPIO27: U10.41 (GPIO27/ADC1); also elsewhere on the board
/GPIO28: U10.42 (GPIO28/ADC2); also elsewhere on the board
/GPIO29: U10.43 (GPIO29/ADC3); also elsewhere on the board
/RESET: U10.19 (GPIO15); also elsewhere on the board
/RUN: R28.2, S1.2, U10.26 (RUN)
/SWCLK: J5.2, U10.24 (SWCLK)
/SWDIO: J5.4, U10.25 (SWDIO)
/SYNC: U10.18 (GPIO14); also elsewhere on the board
/TEMP_ALERT: R49.1, U6.5 (~ALERT), U10.35 (GPIO23)
/TEMP_CS: U6.1 (~CS), U10.37 (GPIO25)
/~ADC_CS: U10.28 (GPIO17); also elsewhere on the board
/~DAC1_CS: U10.31 (GPIO19); also elsewhere on the board
/~DAC2_CS: U10.32 (GPIO20); also elsewhere on the board
/~IRQ/MDAT: U10.29 (GPIO18); also elsewhere on the board
/~LDAC: U10.27 (GPIO16); also elsewhere on the board
COPI: R48.2, U10.34 (GPIO22); also elsewhere on the board
GND: C1.1, C2.1, C3.2, C4.1, C5.1, C6.1, C7.1, C8.1, C9.1, C10.1, C11.1, C12.1, C13.1, C14.1, C15.1, C16.1, C17.2, C18.2, C19.2, C45.2, D3.1 (K), J5.3, J6.A1B12 (GND), J6.B1A12 (GND), J6.S1 (SHELL), J6.S2 (SHELL), J6.S3 (SHELL), J6.S4 (SHELL), R30.2, R31.2, S1.1, S2.1, U5.1 (GND), U5.2 (GND), U6.2 (GND), U8.2, U10.47 (VREG_PGND), U10.61 (GND), U13.1 (GND), X1.2 (GND); also elsewhere on the board
unnamed: D3.2 (A), R47.2
unnamed: J6.A5 (CC1), R31.1
unnamed: J6.B5 (CC2), R30.1
unnamed: J6.A6 (D+), J6.B6 (D+), R33.1
unnamed: J6.A7 (D-), J6.B7 (D-), R32.1
unnamed: Q1.1 (B), U8.1
unnamed: R33.2, U10.52 (USB_D+)
unnamed: R32.2, U10.51 (USB_D-)
unnamed: C12.2, R34.1, U10.46 (VREG_AVDD)
unnamed: L1.2, U10.48 (VREG_LX)
unnamed: U10.21 (XIN), X1.3 (OUT)
SCLK: U6.4 (SCLK), U10.33 (GPIO21); also elsewhere on the board
VBUS: C2.2, C19.1, J6.A4B9 (VBUS), J6.B4A9 (VBUS), Q1.3 (C), U8.5, U13.3 (VIN)
VREF: C18.1, U5.6 (VREF), U8.3; also elsewhere on the board
VREF_BUF: Q1.2 (E), U8.4; also elsewhere on the board

Notes on the sheet:
2.5V REFERENCE
Temperature Sensor
3V3 Supply

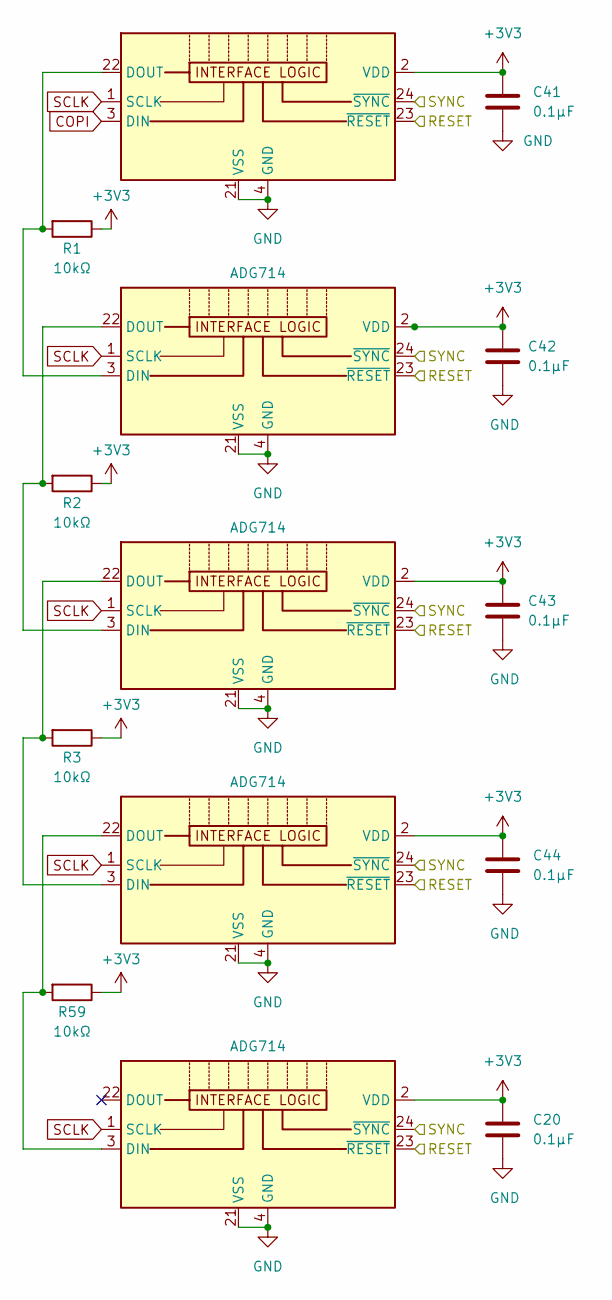
[picture p41: schematic SWITCHES.kicad_sch]

Parts:
C20, C41, C42, C43, C44: 0.1µF; C_0603_1608Metric
R1, R2, R3, R59: 10kΩ; R_0603_1608Metric
U1, U2, U3, U4, U7: ADG714; TSSOP-24_4.4x7.8mm_P0.65mm

Connections:
+3V3: C20.1, C41.1, C42.1, C43.1, C44.1, R1.1, R2.1, R3.1, R59.1, U1.2 (VDD), U2.2 (VDD), U3.2 (VDD), U4.2 (VDD), U7.2 (VDD); also elsewhere on the board
/RESET: U1.23 (~RESET), U2.23 (~RESET), U3.23 (~RESET), U4.23 (~RESET), U7.23 (~RESET); also elsewhere on the board
/SYNC: U1.24 (~SYNC), U2.24 (~SYNC), U3.24 (~SYNC), U4.24 (~SYNC), U7.24 (~SYNC); also elsewhere on the board
COPI: U7.3 (DIN); also elsewhere on the board
GND: C20.2, C41.2, C42.2, C43.2, C44.2, U1.4 (GND), U1.21 (VSS), U2.4 (GND), U2.21 (VSS), U3.4 (GND), U3.21 (VSS), U4.4 (GND), U4.21 (VSS), U7.4 (GND), U7.21 (VSS); also elsewhere on the board
unnamed: R1.2, U1.3 (DIN), U7.22 (DOUT)
unnamed: R2.2, U1.22 (DOUT), U4.3 (DIN)
unnamed: R59.2, U2.3 (DIN), U3.22 (DOUT)
unnamed: R3.2, U3.3 (DIN), U4.22 (DOUT)
SCLK: U1.1 (SCLK), U2.1 (SCLK), U3.1 (SCLK), U4.1 (SCLK), U7.1 (SCLK); also elsewhere on the board

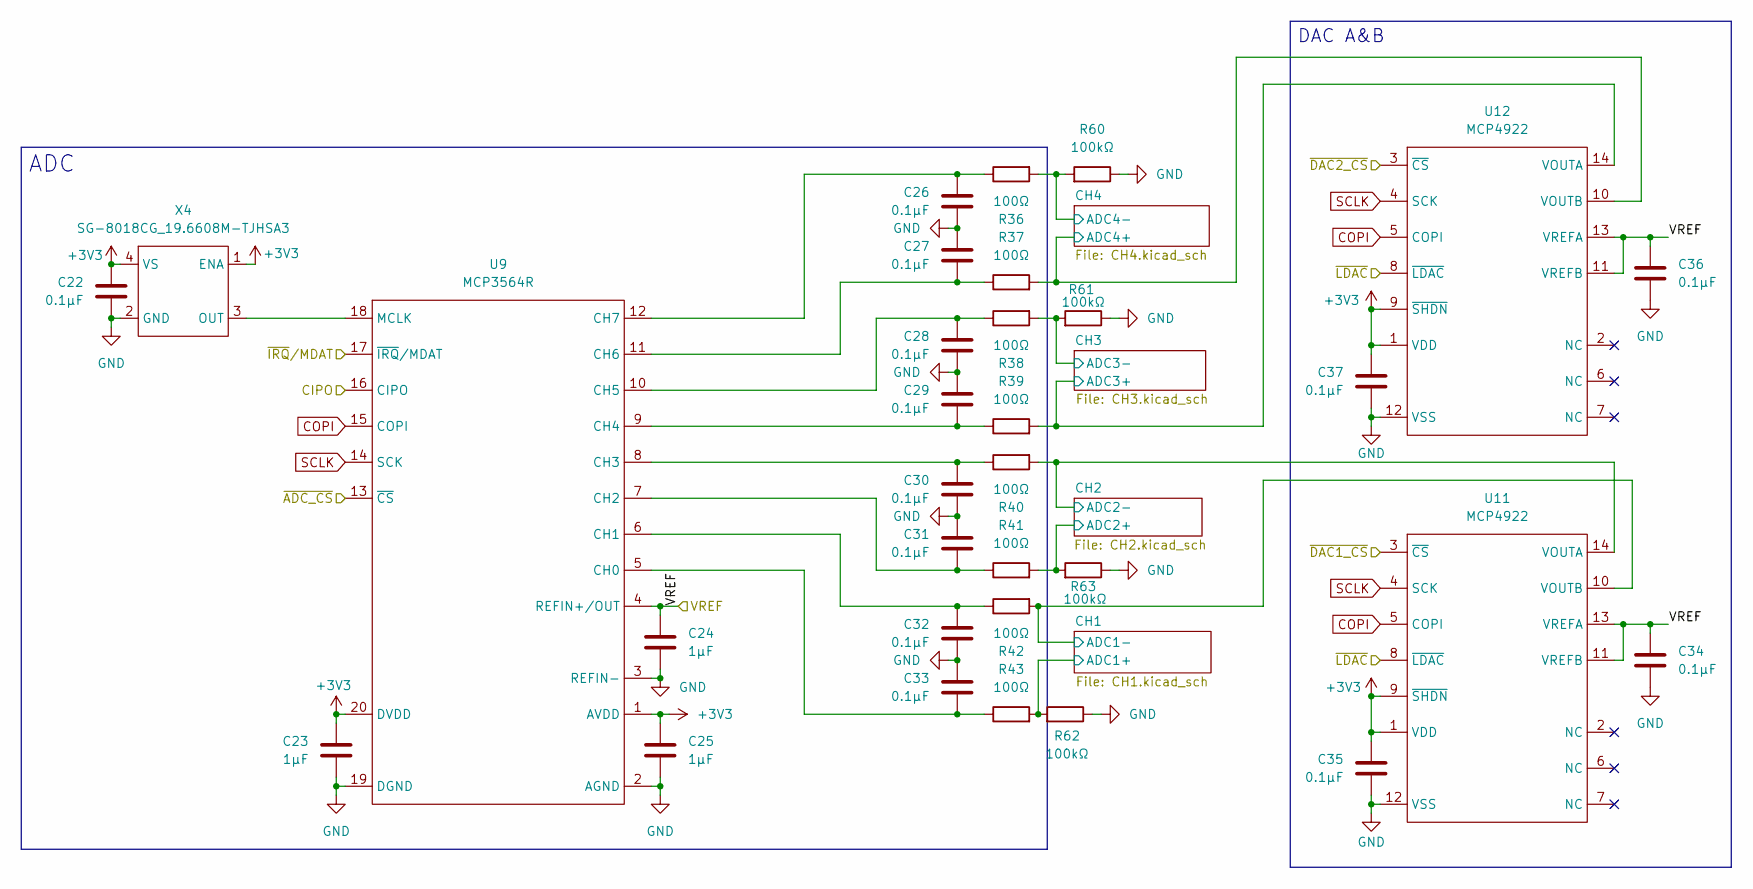
[picture p42: schematic ADC.kicad_sch]

Parts:
C22, C26, C27, C28, C29, C30, C31, C32, C33, C34, C35, C36, C37: 0.1µF; C_0603_1608Metric
C23, C24, C25: 1µF; C_0603_1608Metric
R36, R37, R38, R39, R40, R41, R42, R43: 100Ω; R_0603_1608Metric
R60, R61, R62, R63: 100kΩ; R_0603_1608Metric
U9: MCP3564R; TSSOP-20_4.4x6.5mm_P0.65mm
U11, U12: MCP4922; TSSOP-14_4.4x5mm_P0.65mm
X4: SG-8018CG_19.6608M-TJHSA3; Crystal_SMD_2520-4Pin_2.5x2.0mm

Connections:
+3V3: C22.1, C23.1, C25.1, C35.1, C37.1, U9.1 (AVDD), U9.20 (DVDD), U11.1 (VDD), U11.9 (~SHDN), U12.1 (VDD), U12.9 (~SHDN), X4.1 (ENA), X4.4 (VS); also elsewhere on the board
/ADC/DAC/CH1/ADC1+: R43.2, R62.2; also elsewhere on the board
/ADC/DAC/CH1/ADC1-: R42.2, U11.10 (VOUTB); also elsewhere on the board
/ADC/DAC/CH2/ADC2+: R41.2, R63.2; also elsewhere on the board
/ADC/DAC/CH2/ADC2-: R40.2, U11.14 (VOUTA); also elsewhere on the board
/ADC/DAC/CH3/ADC3+: R39.2, U12.14 (VOUTA); also elsewhere on the board
/ADC/DAC/CH3/ADC3-: R38.2, R61.2; also elsewhere on the board
/ADC/DAC/CH4/ADC4+: R37.2, U12.10 (VOUTB); also elsewhere on the board
/ADC/DAC/CH4/ADC4-: R36.2, R60.2; also elsewhere on the board
/CIPO: U9.16 (CIPO); also elsewhere on the board
/~ADC_CS: U9.13 (~CS); also elsewhere on the board
/~DAC1_CS: U11.3 (~CS); also elsewhere on the board
/~DAC2_CS: U12.3 (~CS); also elsewhere on the board
/~IRQ/MDAT: U9.17 (~IRQ/MDAT); also elsewhere on the board
/~LDAC: U11.8 (~LDAC), U12.8 (~LDAC); also elsewhere on the board
COPI: U9.15 (COPI), U11.5 (COPI), U12.5 (COPI); also elsewhere on the board
GND: C22.2, C23.2, C24.2, C25.2, C26.2, C27.1, C28.2, C29.1, C30.2, C31.1, C32.2, C33.1, C34.2, C35.2, C36.2, C37.2, R60.1, R61.1, R62.1, R63.1, U9.2 (AGND), U9.3 (REFIN-), U9.19 (DGND), U11.12 (VSS), U12.12 (VSS), X4.2 (GND); also elsewhere on the board
unnamed: C33.2, R43.1, U9.5 (CH0)
unnamed: C32.1, R42.1, U9.6 (CH1)
unnamed: C31.2, R41.1, U9.7 (CH2)
unnamed: C30.1, R40.1, U9.8 (CH3)
unnamed: C29.2, R39.1, U9.9 (CH4)
unnamed: C28.1, R38.1, U9.10 (CH5)
unnamed: C27.2, R37.1, U9.11 (CH6)
unnamed: C26.1, R36.1, U9.12 (CH7)
unnamed: U9.18 (MCLK), X4.3 (OUT)
SCLK: U9.14 (SCK), U11.4 (SCK), U12.4 (SCK); also elsewhere on the board
VREF: C24.1, C34.1, C36.1, U9.4 (REFIN+/OUT), U11.11 (VREFB), U11.13 (VREFA), U12.11 (VREFB), U12.13 (VREFA); also elsewhere on the board

Notes on the sheet:
DAC A&B
ADC

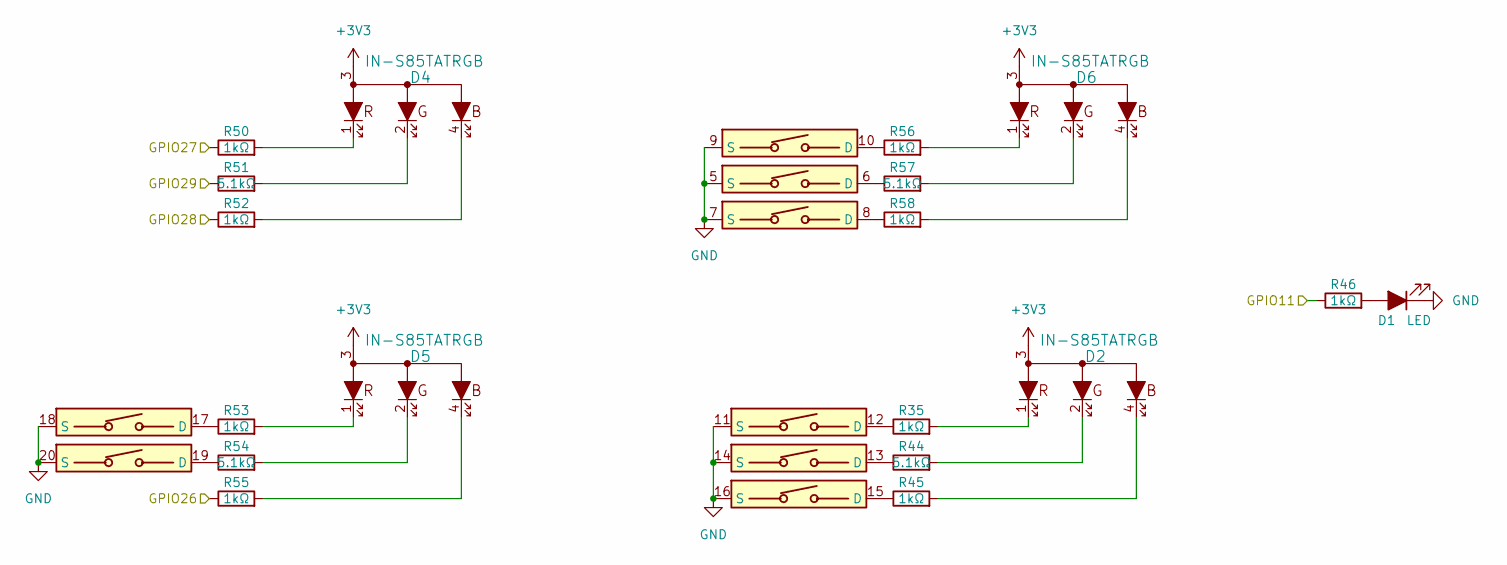
[picture p43: schematic LEDs.kicad_sch]

Parts:
D1: LED; LED_0805_2012Metric
D2, D4, D5, D6: IN-S85TATRGB
R35, R45, R46, R50, R52, R53, R55, R56, R58: 1kΩ; R_0603_1608Metric
R44, R51, R54, R57: 5.1kΩ; R_0603_1608Metric
U7: ADG714; TSSOP-24_4.4x7.8mm_P0.65mm

Connections:
+3V3: D2.3, D4.3, D5.3, D6.3; also elsewhere on the board
/GPIO11: R46.1; also elsewhere on the board
/GPIO26: R55.1; also elsewhere on the board
/GPIO27: R50.1; also elsewhere on the board
/GPIO28: R52.1; also elsewhere on the board
/GPIO29: R51.1; also elsewhere on the board
GND: D1.1 (K), U7.5 (S), U7.7 (S), U7.9 (S), U7.11 (S), U7.14 (S), U7.16 (S), U7.18 (S), U7.20 (S); also elsewhere on the board
unnamed: D1.2 (A), R46.2
unnamed: D2.1, R35.2
unnamed: D2.2, R44.2
unnamed: D2.4, R45.2
unnamed: D4.1, R50.2
unnamed: D4.2, R51.2
unnamed: D4.4, R52.2
unnamed: D5.1, R53.2
unnamed: D5.2, R54.2
unnamed: D5.4, R55.2
unnamed: D6.1, R56.2
unnamed: D6.2, R57.2
unnamed: D6.4, R58.2
unnamed: R57.1, U7.6 (D)
unnamed: R58.1, U7.8 (D)
unnamed: R56.1, U7.10 (D)
unnamed: R35.1, U7.12 (D)
unnamed: R44.1, U7.13 (D)
unnamed: R45.1, U7.15 (D)
unnamed: R53.1, U7.17 (D)
unnamed: R54.1, U7.19 (D)

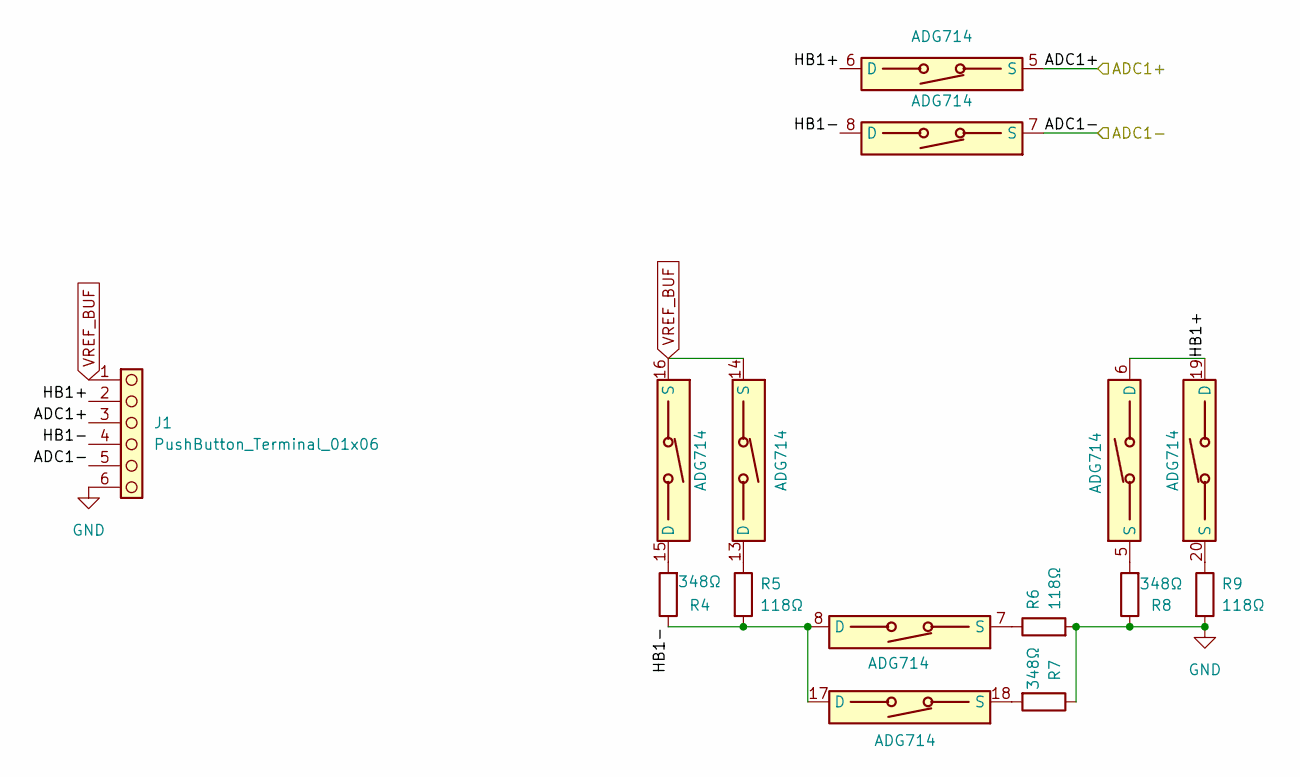
[picture p44: schematic CH1.kicad_sch]

Parts:
J1: PushButton_Terminal_01x06; TerminalBlock_WAGO_233-506_2x06_P2.54mm
R4, R7, R8: 348Ω; R_0603_1608Metric
R5, R6, R9: 118Ω; R_0603_1608Metric
U1, U2, U3: ADG714; TSSOP-24_4.4x7.8mm_P0.65mm

Connections:
/ADC/DAC/CH1/ADC1+: J1.3, U3.5 (S); also elsewhere on the board
/ADC/DAC/CH1/ADC1-: J1.5, U3.7 (S); also elsewhere on the board
/ADC/DAC/CH1/HB1+: J1.2, U2.6 (D), U2.19 (D), U3.6 (D)
/ADC/DAC/CH1/HB1-: J1.4, R4.1, R5.2, U2.8 (D), U2.17 (D), U3.8 (D)
GND: J1.6, R6.2, R7.1, R8.1, R9.2; also elsewhere on the board
unnamed: R5.1, U1.13 (D)
unnamed: R4.2, U1.15 (D)
unnamed: R8.2, U2.5 (S)
unnamed: R6.1, U2.7 (S)
unnamed: R7.2, U2.18 (S)
unnamed: R9.1, U2.20 (S)
VREF_BUF: J1.1, U1.14 (S), U1.16 (S); also elsewhere on the board

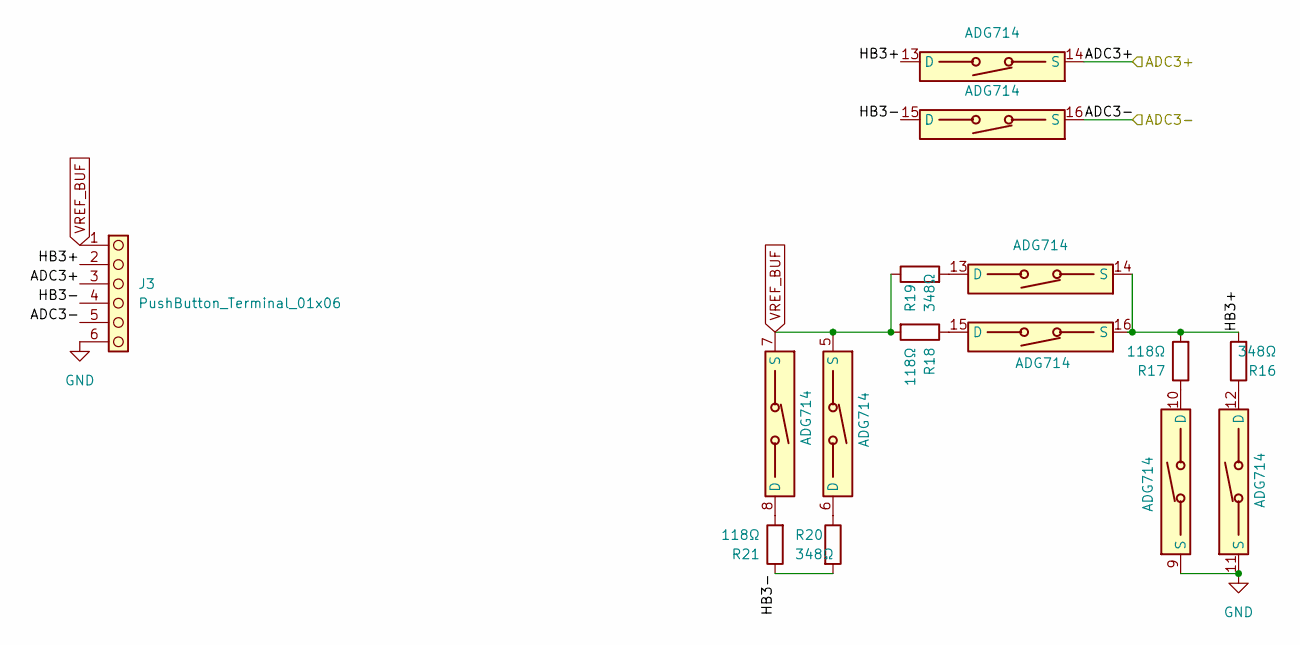
[picture p45: schematic CH3.kicad_sch]

Parts:
J3: PushButton_Terminal_01x06; TerminalBlock_WAGO_233-506_2x06_P2.54mm
R16, R19, R20: 348Ω; R_0603_1608Metric
R17, R18, R21: 118Ω; R_0603_1608Metric
U1, U3, U4: ADG714; TSSOP-24_4.4x7.8mm_P0.65mm

Connections:
/ADC/DAC/CH3/ADC3+: J3.3, U3.14 (S); also elsewhere on the board
/ADC/DAC/CH3/ADC3-: J3.5, U3.16 (S); also elsewhere on the board
/ADC/DAC/CH3/HB3+: J3.2, R16.2, R17.2, U3.13 (D), U4.14 (S), U4.16 (S)
/ADC/DAC/CH3/HB3-: J3.4, R20.2, R21.1, U3.15 (D)
GND: J3.6, U4.9 (S), U4.11 (S); also elsewhere on the board
unnamed: R20.1, U1.6 (D)
unnamed: R21.2, U1.8 (D)
unnamed: R17.1, U4.10 (D)
unnamed: R16.1, U4.12 (D)
unnamed: R19.2, U4.13 (D)
unnamed: R18.1, U4.15 (D)
VREF_BUF: J3.1, R18.2, R19.1, U1.5 (S), U1.7 (S); also elsewhere on the board

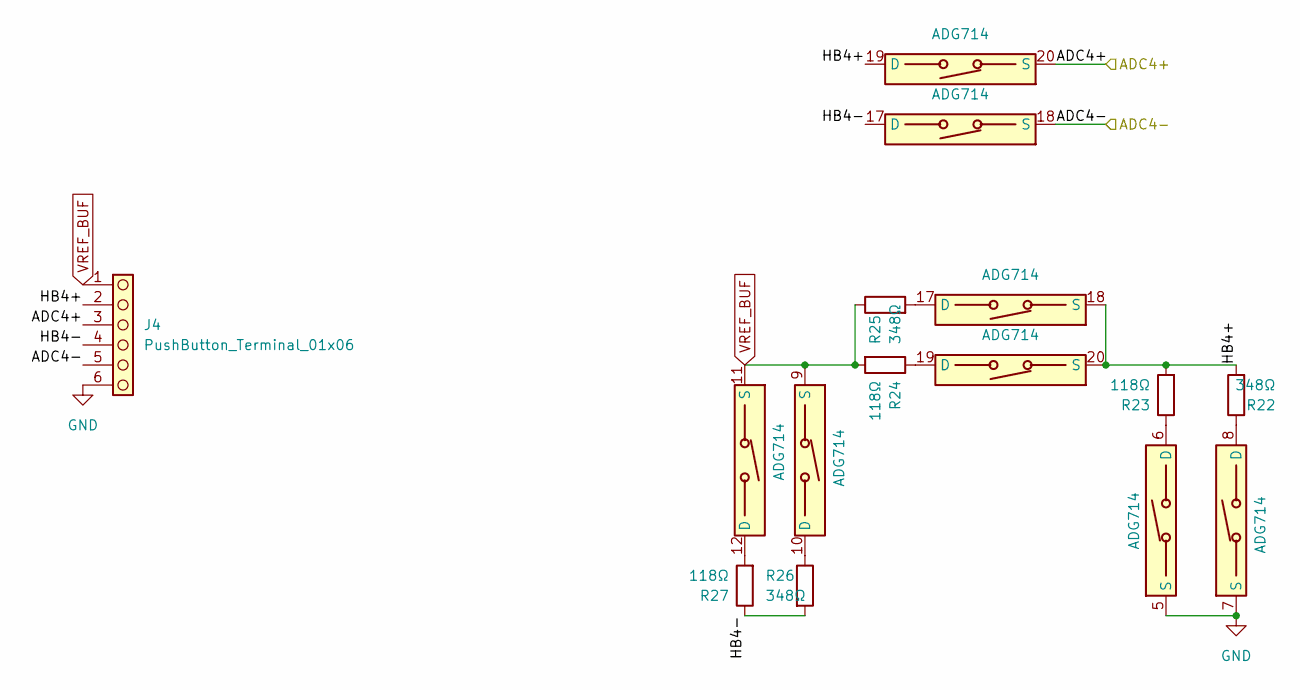
[picture p46: schematic CH4.kicad_sch]

Parts:
J4: PushButton_Terminal_01x06; TerminalBlock_WAGO_233-506_2x06_P2.54mm
R22, R25, R26: 348Ω; R_0603_1608Metric
R23, R24, R27: 118Ω; R_0603_1608Metric
U1, U3, U4: ADG714; TSSOP-24_4.4x7.8mm_P0.65mm

Connections:
/ADC/DAC/CH4/ADC4+: J4.3, U3.20 (S); also elsewhere on the board
/ADC/DAC/CH4/ADC4-: J4.5, U3.18 (S); also elsewhere on the board
/ADC/DAC/CH4/HB4+: J4.2, R22.2, R23.2, U3.19 (D), U4.18 (S), U4.20 (S)
/ADC/DAC/CH4/HB4-: J4.4, R26.2, R27.1, U3.17 (D)
GND: J4.6, U4.5 (S), U4.7 (S); also elsewhere on the board
unnamed: R26.1, U1.10 (D)
unnamed: R27.2, U1.12 (D)
unnamed: R23.1, U4.6 (D)
unnamed: R22.1, U4.8 (D)
unnamed: R25.2, U4.17 (D)
unnamed: R24.1, U4.19 (D)
VREF_BUF: J4.1, R24.2, R25.1, U1.9 (S), U1.11 (S); also elsewhere on the board

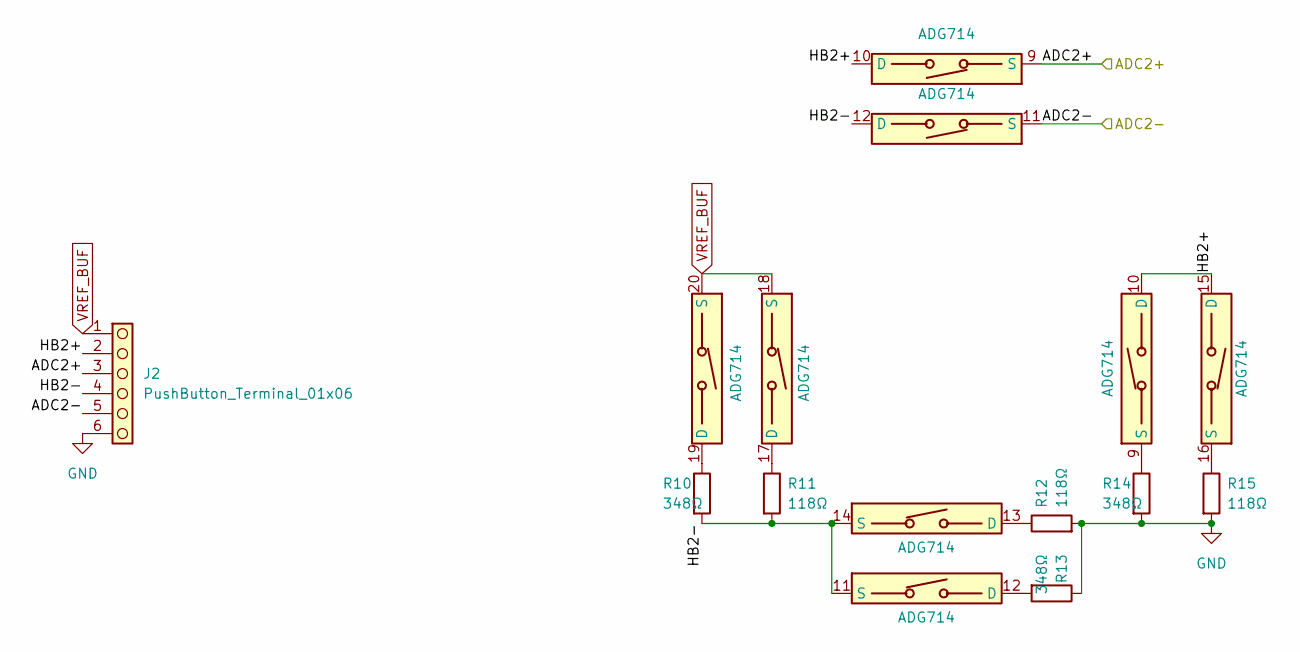
[picture p47: schematic CH2.kicad_sch]

Parts:
J2: PushButton_Terminal_01x06; TerminalBlock_WAGO_233-506_2x06_P2.54mm
R10, R13, R14: 348Ω; R_0603_1608Metric
R11, R12, R15: 118Ω; R_0603_1608Metric
U1, U2, U3: ADG714; TSSOP-24_4.4x7.8mm_P0.65mm

Connections:
/ADC/DAC/CH2/ADC2+: J2.3, U3.9 (S); also elsewhere on the board
/ADC/DAC/CH2/ADC2-: J2.5, U3.11 (S); also elsewhere on the board
/ADC/DAC/CH2/HB2+: J2.2, U2.10 (D), U2.15 (D), U3.10 (D)
/ADC/DAC/CH2/HB2-: J2.4, R10.2, R11.2, U2.11 (S), U2.14 (S), U3.12 (D)
GND: J2.6, R12.2, R13.1, R14.2, R15.2; also elsewhere on the board
unnamed: R11.1, U1.17 (D)
unnamed: R10.1, U1.19 (D)
unnamed: R14.1, U2.9 (S)
unnamed: R13.2, U2.12 (D)
unnamed: R12.1, U2.13 (D)
unnamed: R15.1, U2.16 (S)
VREF_BUF: J2.1, U1.18 (S), U1.20 (S); also elsewhere on the board

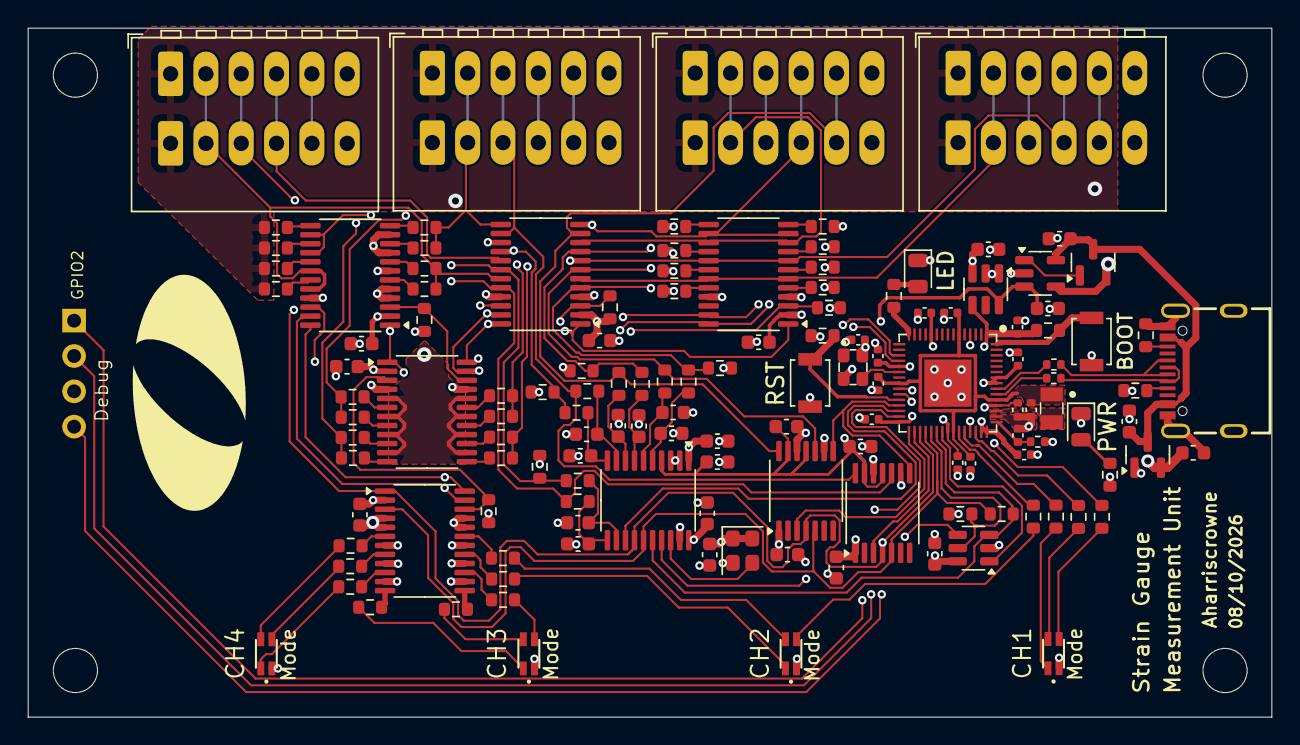
[picture p48: board me_gizmo.kicad_pcb from above]

Board: 4 copper layers, 89.4 x 49.5 mm, 136 parts (0 on the bottom side), 113 nets.

Other parts of the board:
svg2mod: G***; OlinLogo_0.3in
