bminch/me_gizmo/PCBs/me_gizmo/WB_Breakout/WB_Breakout.kicad_pcb

## KiCad design PCBs/me_gizmo/WB_Breakout/WB_Breakout.kicad_pcb (2026-07-16)

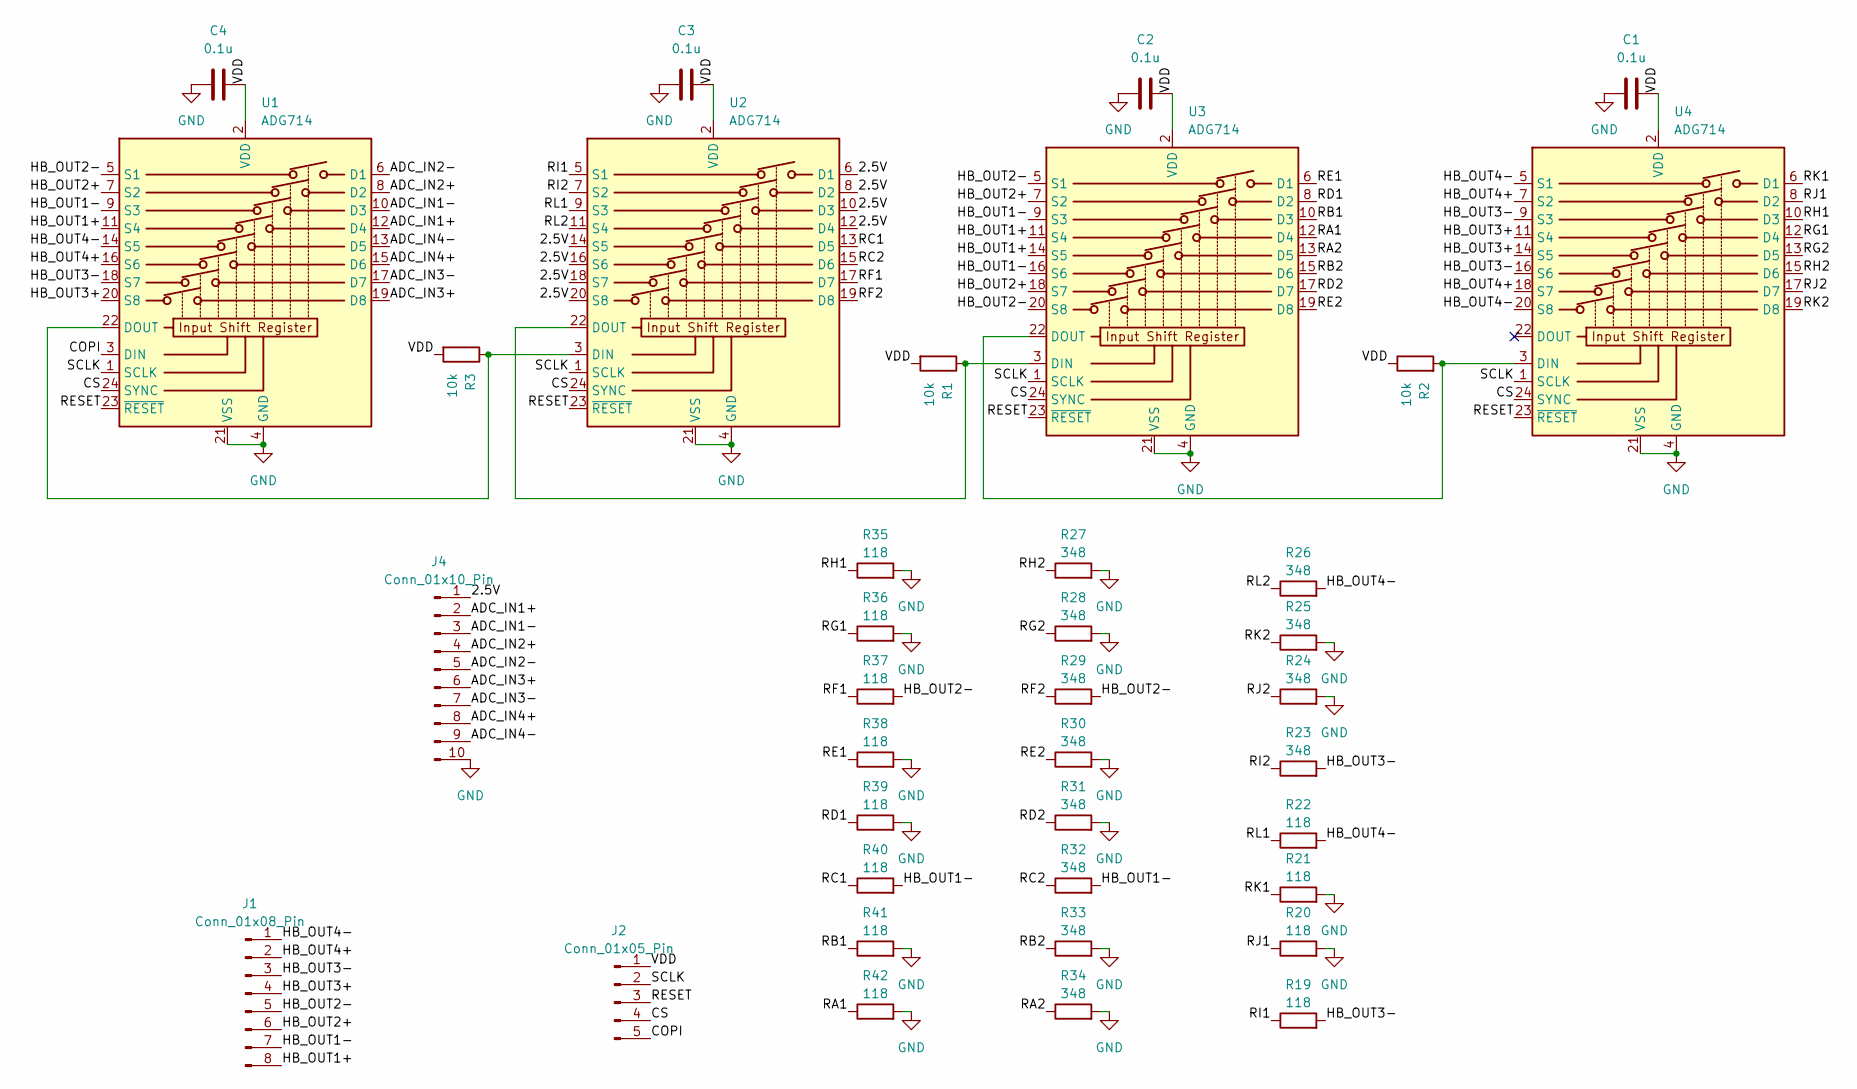
[picture p49: schematic WB_Breakout.kicad_sch]

Parts:
C1, C2, C3, C4: 0.1u; C_0603_1608Metric
J1: Conn_01x08_Pin; PinHeader_1x08_P2.54mm_Vertical
J2: Conn_01x05_Pin; PinHeader_1x05_P2.54mm_Vertical
J4: Conn_01x10_Pin; PinHeader_1x10_P2.54mm_Vertical
R1, R2, R3: 10k; R_0603_1608Metric
R19, R20, R21, R22, R35, R36, R37, R38, R39, R40, R41, R42: 118; R_0603_1608Metric
R23, R24, R25, R26, R27, R28, R29, R30, R31, R32, R33, R34: 348; R_0603_1608Metric
U1, U2, U3, U4: ADG714; TSSOP-24_4.4x7.8mm_P0.65mm

Connections:
/2.5V: J4.1, U2.6 (D1), U2.8 (D2), U2.10 (D3), U2.12 (D4), U2.14 (S5), U2.16 (S6), U2.18 (S7), U2.20 (S8)
/ADC_IN1+: J4.2, U1.12 (D4)
/ADC_IN1-: J4.3, U1.10 (D3)
/ADC_IN2+: J4.4, U1.8 (D2)
/ADC_IN2-: J4.5, U1.6 (D1)
/ADC_IN3+: J4.6, U1.19 (D8)
/ADC_IN3-: J4.7, U1.17 (D7)
/ADC_IN4+: J4.8, U1.15 (D6)
/ADC_IN4-: J4.9, U1.13 (D5)
/COPI: J2.5, U1.3 (DIN)
/CS: J2.4, U1.24 (SYNC), U2.24 (SYNC), U3.24 (SYNC), U4.24 (SYNC)
/HB_OUT1+: J1.8, U1.11 (S4), U3.11 (S4), U3.14 (S5)
/HB_OUT1-: J1.7, R32.2, R40.2, U1.9 (S3), U3.9 (S3), U3.16 (S6)
/HB_OUT2+: J1.6, U1.7 (S2), U3.7 (S2), U3.18 (S7)
/HB_OUT2-: J1.5, R29.2, R37.2, U1.5 (S1), U3.5 (S1), U3.20 (S8)
/HB_OUT3+: J1.4, U1.20 (S8), U4.11 (S4), U4.14 (S5)
/HB_OUT3-: J1.3, R19.2, R23.2, U1.18 (S7), U4.9 (S3), U4.16 (S6)
/HB_OUT4+: J1.2, U1.16 (S6), U4.7 (S2), U4.18 (S7)
/HB_OUT4-: J1.1, R22.2, R26.2, U1.14 (S5), U4.5 (S1), U4.20 (S8)
/RA1: R42.1, U3.12 (D4)
/RA2: R34.1, U3.13 (D5)
/RB1: R41.1, U3.10 (D3)
/RB2: R33.1, U3.15 (D6)
/RC1: R40.1, U2.13 (D5)
/RC2: R32.1, U2.15 (D6)
/RD1: R39.1, U3.8 (D2)
/RD2: R31.1, U3.17 (D7)
/RE1: R38.1, U3.6 (D1)
/RE2: R30.1, U3.19 (D8)
/RESET: J2.3, U1.23 (~RESET), U2.23 (~RESET), U3.23 (~RESET), U4.23 (~RESET)
/RF1: R37.1, U2.17 (D7)
/RF2: R29.1, U2.19 (D8)
/RG1: R36.1, U4.12 (D4)
/RG2: R28.1, U4.13 (D5)
/RH1: R35.1, U4.10 (D3)
/RH2: R27.1, U4.15 (D6)
/RI1: R19.1, U2.5 (S1)
/RI2: R23.1, U2.7 (S2)
/RJ1: R20.1, U4.8 (D2)
/RJ2: R24.1, U4.17 (D7)
/RK1: R21.1, U4.6 (D1)
/RK2: R25.1, U4.19 (D8)
/RL1: R22.1, U2.9 (S3)
/RL2: R26.1, U2.11 (S4)
/SCLK: J2.2, U1.1 (SCLK), U2.1 (SCLK), U3.1 (SCLK), U4.1 (SCLK)
/VDD: C1.2, C2.2, C3.2, C4.2, J2.1, R1.2, R2.1, R3.2, U1.2 (VDD), U2.2 (VDD), U3.2 (VDD), U4.2 (VDD)
GND: C1.1, C2.1, C3.1, C4.1, J4.10, R20.2, R21.2, R24.2, R25.2, R27.2, R28.2, R30.2, R31.2, R33.2, R34.2, R35.2, R36.2, R38.2, R39.2, R41.2, R42.2, U1.4 (GND), U1.21 (VSS), U2.4 (GND), U2.21 (VSS), U3.4 (GND), U3.21 (VSS), U4.4 (GND), U4.21 (VSS)
unnamed: R3.1, U1.22 (DOUT), U2.3 (DIN)
unnamed: R1.1, U2.22 (DOUT), U3.3 (DIN)
unnamed: R2.2, U3.22 (DOUT), U4.3 (DIN)

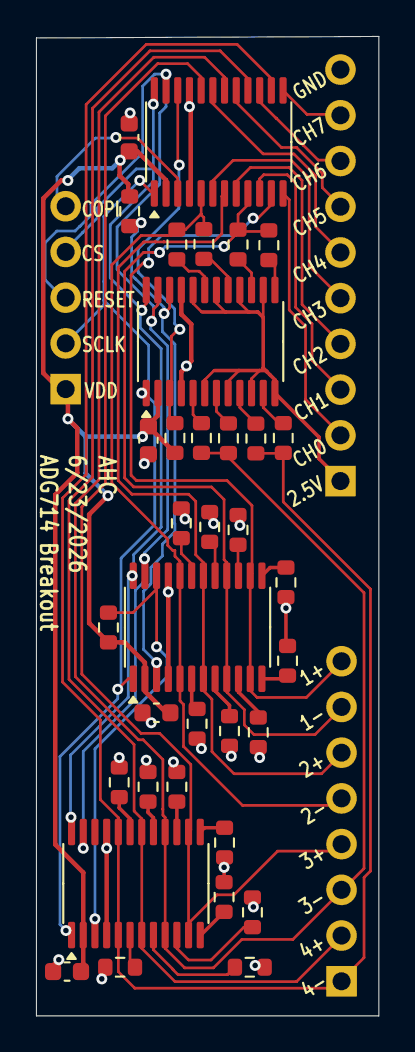
[picture p50: board WB_Breakout.kicad_pcb from above]

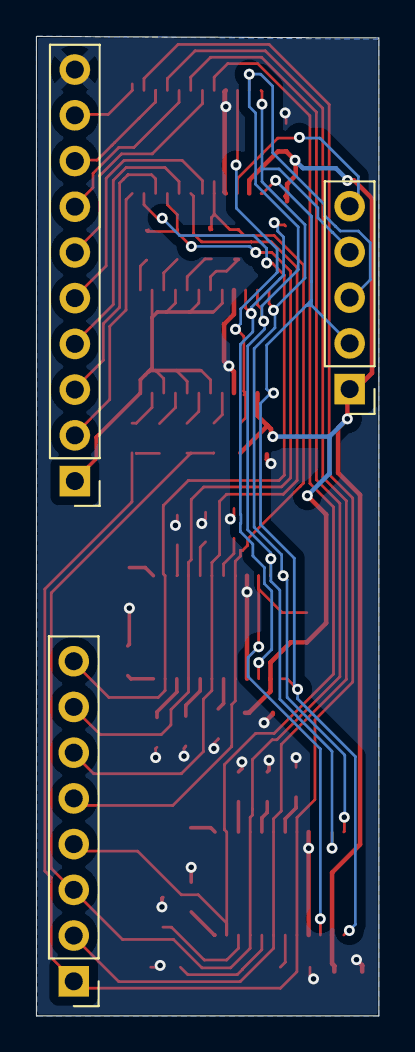
[picture p51: board WB_Breakout.kicad_pcb from below]

Board: 2 copper layers, 19.0 x 54.4 mm, 38 parts (3 on the bottom side), 50 nets.
