bminch/me_gizmo/PCBs/rp2350dev/rp2350dev.kicad_pcb

## KiCad design PCBs/rp2350dev/rp2350dev.kicad_pcb (2026-06-29)

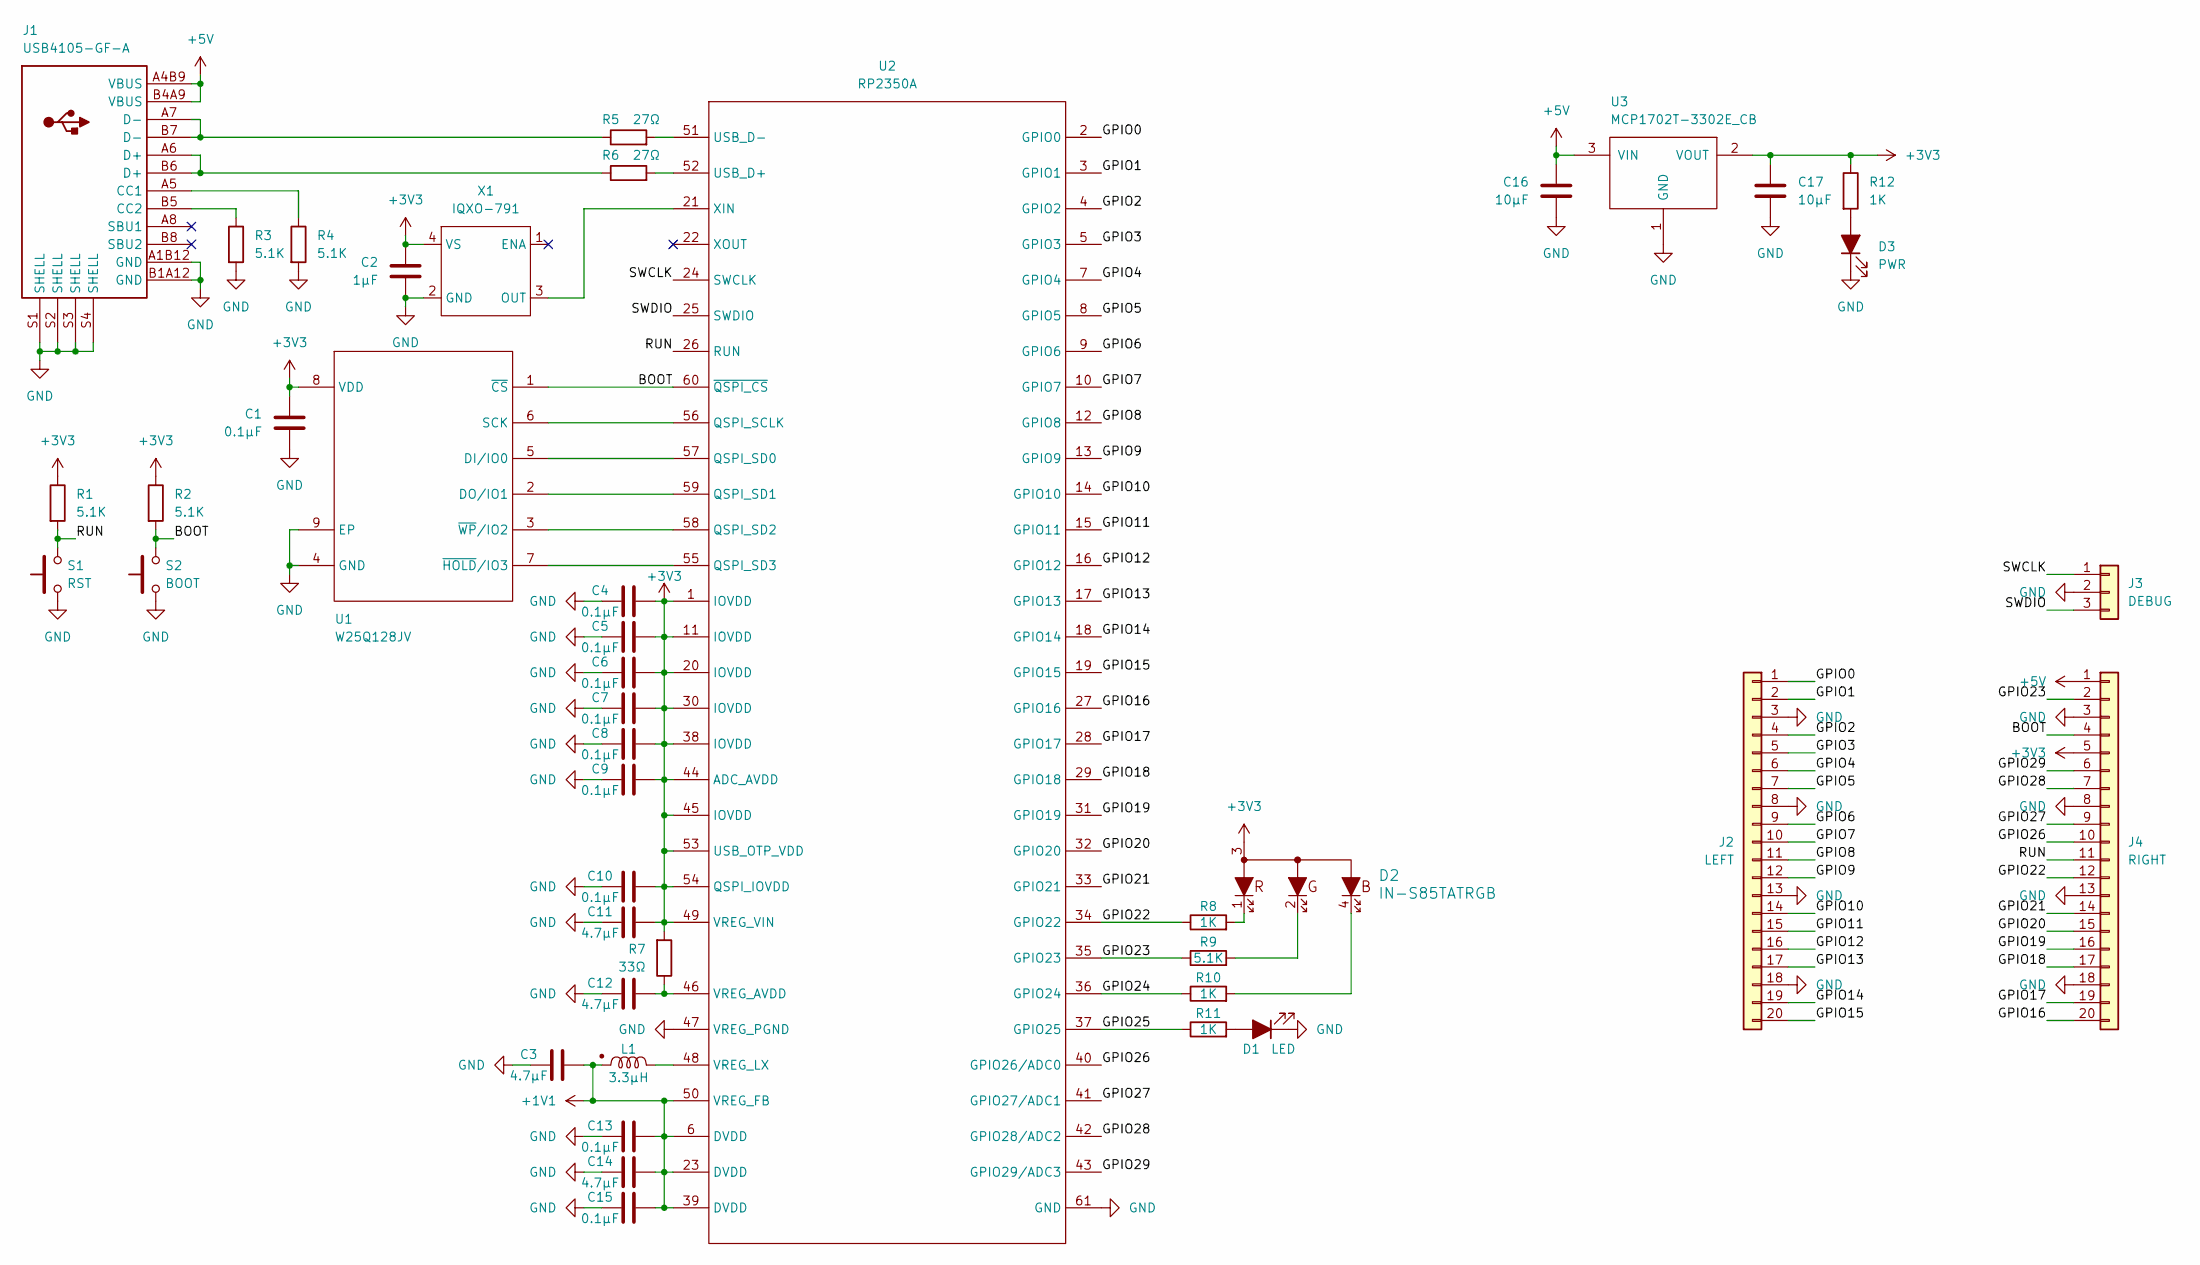
[picture p52: schematic rp2350dev.kicad_sch, RP2350A Development Board]

Parts:
C1, C4, C5, C6, C7, C8, C9, C10, C13, C15: 0.1µF; C_0402_1005Metric
C2: 1µF; C_0402_1005Metric
C3, C11, C12, C14: 4.7µF; C_0402_1005Metric
C16, C17: 10µF; C_0603_1608Metric
D1: LED; LED_0805_2012Metric
D2: IN-S85TATRGB
D3: PWR; LED_0805_2012Metric
J1: USB4105-GF-A
J2: LEFT; PinHeader_1x20_P2.54mm_Vertical
J3: DEBUG; PinHeader_1x03_P2.54mm_Vertical
J4: RIGHT; PinHeader_1x20_P2.54mm_Vertical
L1: 3.3µH; AOTA-B201610S3R3-101-T
R1, R2, R3, R4, R9: 5.1K; R_0402_1005Metric
R5, R6: 27Ω; R_0402_1005Metric
R7: 33Ω; R_0402_1005Metric
R8, R10, R11, R12: 1K; R_0402_1005Metric
S1: RST; SW_SPST_B3U-1000P
S2: BOOT; SW_SPST_B3U-1000P
U1: W25Q128JV; WSON-8-1EP_6x5mm_P1.27mm_EP3.4x4.3mm
U2: RP2350A; RP2350A_QFN-60_EP_7.75x7.75_Pitch0.4mm
U3: MCP1702T-3302E_CB; SOT-23
X1: IQXO-791

Connections:
+1V1: C3.2, C13.2, C14.2, C15.2, L1.1, U2.6 (DVDD), U2.23 (DVDD), U2.39 (DVDD), U2.50 (VREG_FB)
+3V3: C1.2, C2.2, C4.2, C5.2, C6.2, C7.2, C8.2, C9.2, C10.2, C11.2, C17.1, D2.3, J4.5, R1.1, R2.1, R7.2, R12.1, U1.8 (VDD), U2.1 (IOVDD), U2.11 (IOVDD), U2.20 (IOVDD), U2.30 (IOVDD), U2.38 (IOVDD), U2.44 (ADC_AVDD), U2.45 (IOVDD), U2.49 (VREG_VIN), U2.53 (USB_OTP_VDD), U2.54 (QSPI_IOVDD), U3.2 (VOUT), X1.4 (VS)
+5V: C16.2, J1.A4B9 (VBUS), J1.B4A9 (VBUS), J4.1, U3.3 (VIN)
/BOOT: J4.4, R2.2, S2.2, U1.1 (~CS), U2.60 (~QSPI_CS)
/GPIO0: J2.1, U2.2 (GPIO0)
/GPIO1: J2.2, U2.3 (GPIO1)
/GPIO2: J2.4, U2.4 (GPIO2)
/GPIO3: J2.5, U2.5 (GPIO3)
/GPIO4: J2.6, U2.7 (GPIO4)
/GPIO5: J2.7, U2.8 (GPIO5)
/GPIO6: J2.9, U2.9 (GPIO6)
/GPIO7: J2.10, U2.10 (GPIO7)
/GPIO8: J2.11, U2.12 (GPIO8)
/GPIO9: J2.12, U2.13 (GPIO9)
/GPIO10: J2.14, U2.14 (GPIO10)
/GPIO11: J2.15, U2.15 (GPIO11)
/GPIO12: J2.16, U2.16 (GPIO12)
/GPIO13: J2.17, U2.17 (GPIO13)
/GPIO14: J2.19, U2.18 (GPIO14)
/GPIO15: J2.20, U2.19 (GPIO15)
/GPIO16: J4.20, U2.27 (GPIO16)
/GPIO17: J4.19, U2.28 (GPIO17)
/GPIO18: J4.17, U2.29 (GPIO18)
/GPIO19: J4.16, U2.31 (GPIO19)
/GPIO20: J4.15, U2.32 (GPIO20)
/GPIO21: J4.14, U2.33 (GPIO21)
/GPIO22: J4.12, R8.1, U2.34 (GPIO22)
/GPIO23: J4.2, R9.1, U2.35 (GPIO23)
/GPIO24: R10.1, U2.36 (GPIO24)
/GPIO25: R11.1, U2.37 (GPIO25)
/GPIO26: J4.10, U2.40 (GPIO26/ADC0)
/GPIO27: J4.9, U2.41 (GPIO27/ADC1)
/GPIO28: J4.7, U2.42 (GPIO28/ADC2)
/GPIO29: J4.6, U2.43 (GPIO29/ADC3)
/RUN: J4.11, R1.2, S1.2, U2.26 (RUN)
/SWCLK: J3.1, U2.24 (SWCLK)
/SWDIO: J3.3, U2.25 (SWDIO)
GND: C1.1, C2.1, C3.1, C4.1, C5.1, C6.1, C7.1, C8.1, C9.1, C10.1, C11.1, C12.1, C13.1, C14.1, C15.1, C16.1, C17.2, D1.1 (K), D3.1 (K), J1.A1B12 (GND), J1.B1A12 (GND), J1.S1 (SHELL), J1.S2 (SHELL), J1.S3 (SHELL), J1.S4 (SHELL), J2.3, J2.8, J2.13, J2.18, J3.2, J4.3, J4.8, J4.13, J4.18, R3.2, R4.2, S1.1, S2.1, U1.4 (GND), U1.9 (EP), U2.47 (VREG_PGND), U2.61 (GND), U3.1 (GND), X1.2 (GND)
unnamed: D1.2 (A), R11.2
unnamed: D2.1, R8.2
unnamed: D2.2, R9.2
unnamed: D2.4, R10.2
unnamed: D3.2 (A), R12.2
unnamed: J1.A5 (CC1), R4.1
unnamed: J1.B5 (CC2), R3.1
unnamed: J1.A6 (D+), J1.B6 (D+), R6.1
unnamed: J1.A7 (D-), J1.B7 (D-), R5.1
unnamed: U1.5 (DI/IO0), U2.57 (QSPI_SD0)
unnamed: U1.2 (DO/IO1), U2.59 (QSPI_SD1)
unnamed: U1.6 (SCK), U2.56 (QSPI_SCLK)
unnamed: U1.7 (~HOLD/IO3), U2.55 (QSPI_SD3)
unnamed: U1.3 (~WP/IO2), U2.58 (QSPI_SD2)
unnamed: R6.2, U2.52 (USB_D+)
unnamed: R5.2, U2.51 (USB_D-)
unnamed: C12.2, R7.1, U2.46 (VREG_AVDD)
unnamed: L1.2, U2.48 (VREG_LX)
unnamed: U2.21 (XIN), X1.3 (OUT)

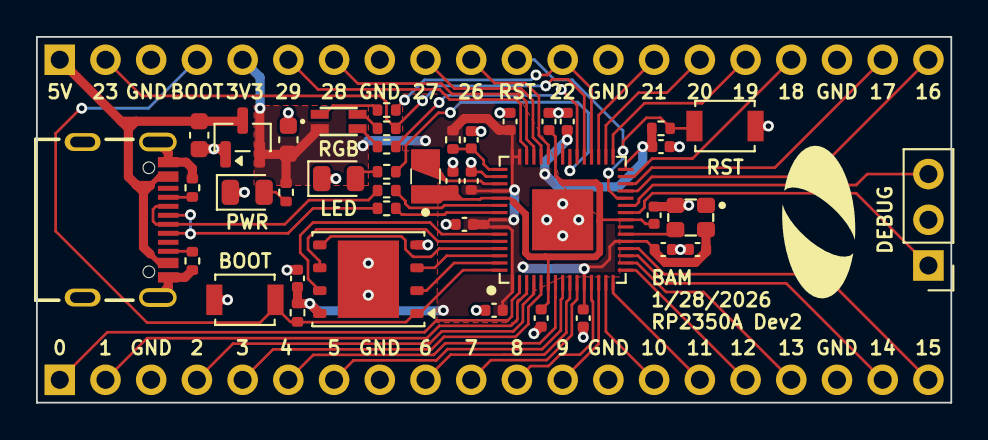
[picture p53: board rp2350dev.kicad_pcb from above]

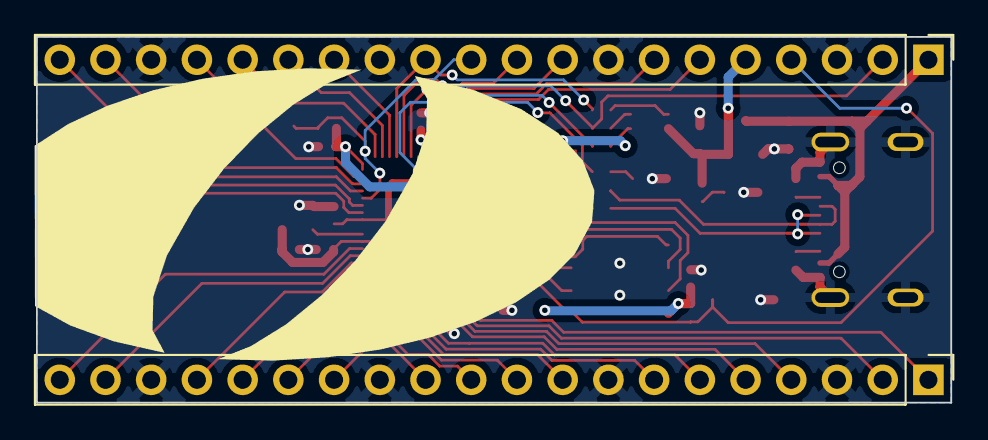
[picture p54: board rp2350dev.kicad_pcb from below]

Board: 2 copper layers, 50.8 x 20.3 mm, 45 parts (3 on the bottom side), 57 nets.

Other parts of the board:
OlinLogoLg1: G***; OlinLogoLg1
OlinLogoTruncated_0.6in: G***; OlinLogoTruncated_0.6in
