bminch/me_gizmo/PCBs/me_gizmo/LED_Breakout/LED_Breakout.kicad_pcb

## KiCad design PCBs/me_gizmo/LED_Breakout/LED_Breakout.kicad_pcb (2026-06-25)

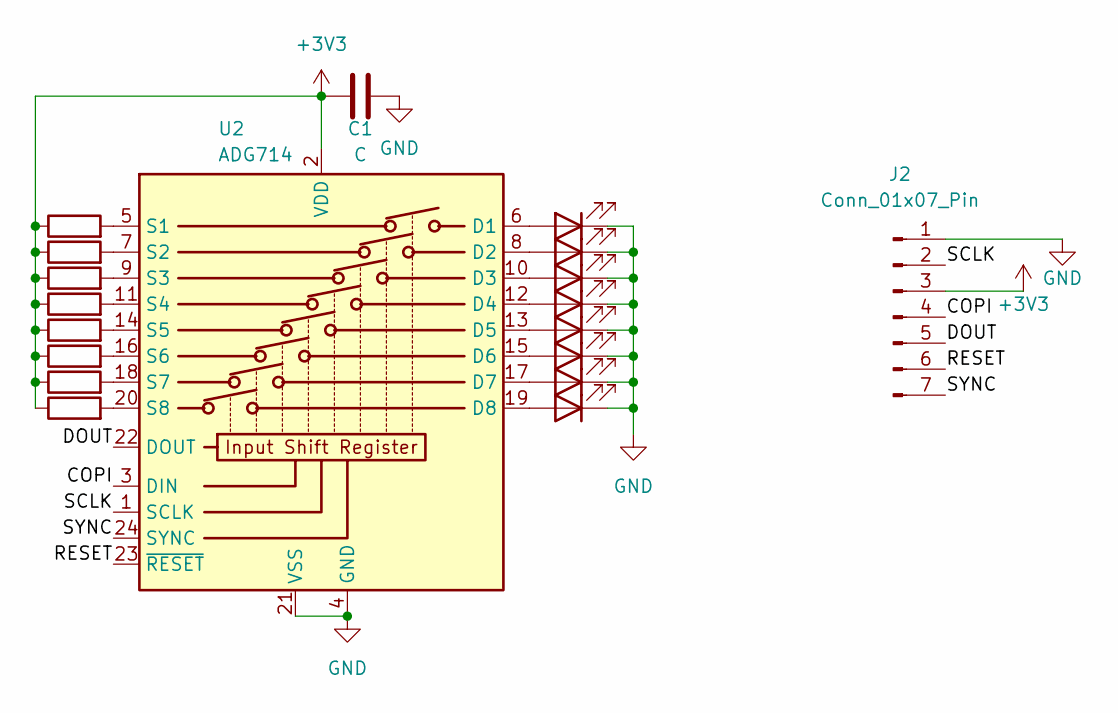
[picture p55: schematic LED_Breakout.kicad_sch]

Parts:
C1: C; C_0603_1608Metric
D1, D2, D3, D4, D5, D6, D7, D8: LED; D_0603_1608Metric
J2: Conn_01x07_Pin; PinHeader_1x07_P2.54mm_Vertical
R1, R2, R3, R4, R5, R6, R7, R8: R; R_0603_1608Metric
U2: ADG714; TSSOP-24_4.4x7.8mm_P0.65mm

Connections:
+3V3: C1.1, J2.3, R1.1, R2.1, R3.1, R4.1, R5.1, R6.1, R7.1, R8.1, U2.2 (VDD)
/COPI: J2.4, U2.3 (DIN)
/DOUT: J2.5, U2.22 (DOUT)
/RESET: J2.6, U2.23 (~RESET)
/SCLK: J2.2, U2.1 (SCLK)
/SYNC: J2.7, U2.24 (SYNC)
GND: C1.2, D1.1 (K), D2.1 (K), D3.1 (K), D4.1 (K), D5.1 (K), D6.1 (K), D7.1 (K), D8.1 (K), J2.1, U2.4 (GND), U2.21 (VSS)
unnamed: D1.2 (A), U2.12 (D4)
unnamed: D2.2 (A), U2.10 (D3)
unnamed: D3.2 (A), U2.8 (D2)
unnamed: D4.2 (A), U2.6 (D1)
unnamed: D5.2 (A), U2.19 (D8)
unnamed: D6.2 (A), U2.17 (D7)
unnamed: D7.2 (A), U2.15 (D6)
unnamed: D8.2 (A), U2.13 (D5)
unnamed: R1.2, U2.5 (S1)
unnamed: R2.2, U2.7 (S2)
unnamed: R3.2, U2.9 (S3)
unnamed: R4.2, U2.11 (S4)
unnamed: R5.2, U2.14 (S5)
unnamed: R6.2, U2.16 (S6)
unnamed: R7.2, U2.18 (S7)
unnamed: R8.2, U2.20 (S8)

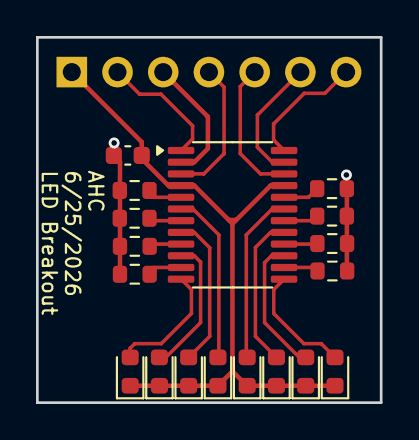
[picture p56: board LED_Breakout.kicad_pcb from above]

Board: 2 copper layers, 19.1 x 20.3 mm, 19 parts (1 on the bottom side), 23 nets.
