bminch/me_gizmo/PCBs/mcp3564rbreakout/mcp3564rbreakout.kicad_pcb

## KiCad design PCBs/mcp3564rbreakout/mcp3564rbreakout.kicad_pcb (2026-06-11)

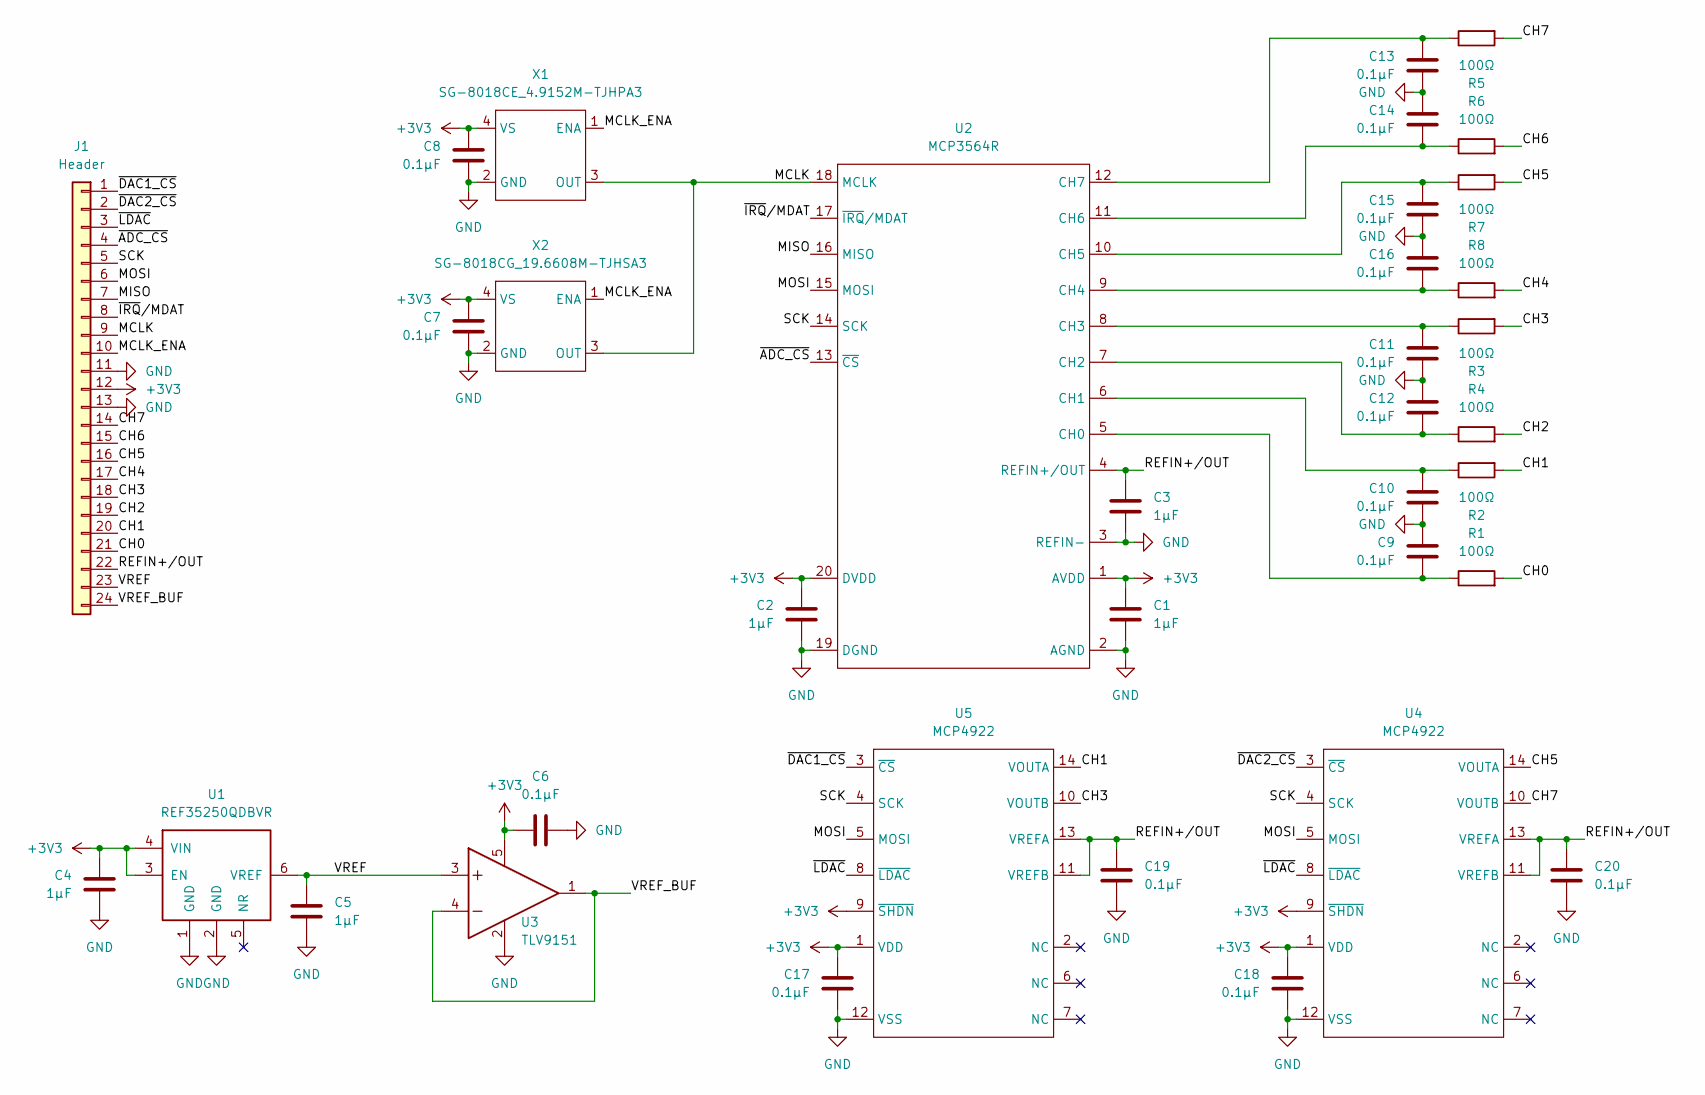
[picture p57: schematic mcp3564rbreakout.kicad_sch, MCP3564R Breakout]

Parts:
C1, C2, C3, C4, C5: 1µF; C_0603_1608Metric
C6, C7, C8, C9, C10, C11, C12, C13, C14, C15, C16, C17, C18, C19, C20: 0.1µF; C_0603_1608Metric
J1: Header; PinHeader_1x24_P2.54mm_Vertical
R1, R2, R3, R4, R5, R6, R7, R8: 100Ω; R_0603_1608Metric
U1: REF35250QDBVR; SOT-23-6
U2: MCP3564R; TSSOP-20_4.4x6.5mm_P0.65mm
U3: TLV9151; SOT-23-5
U4, U5: MCP4922; TSSOP-14_4.4x5mm_P0.65mm
X1: SG-8018CE_4.9152M-TJHPA3; Crystal_SMD_3225-4Pin_3.2x2.5mm
X2: SG-8018CG_19.6608M-TJHSA3; Crystal_SMD_2520-4Pin_2.5x2.0mm

Connections:
+3V3: C1.1, C2.1, C4.1, C6.1, C7.1, C8.1, C17.1, C18.1, J1.12, U1.3 (EN), U1.4 (VIN), U2.1 (AVDD), U2.20 (DVDD), U3.5, U4.1 (VDD), U4.9 (~SHDN), U5.1 (VDD), U5.9 (~SHDN), X1.4 (VS), X2.4 (VS)
/CH0: J1.21, R1.2
/CH1: J1.20, R2.2, U5.14 (VOUTA)
/CH2: J1.19, R4.2
/CH3: J1.18, R3.2, U5.10 (VOUTB)
/CH4: J1.17, R8.2
/CH5: J1.16, R7.2, U4.14 (VOUTA)
/CH6: J1.15, R6.2
/CH7: J1.14, R5.2, U4.10 (VOUTB)
/MCLK: J1.9, U2.18 (MCLK), X1.3 (OUT), X2.3 (OUT)
/MCLK_ENA: J1.10, X1.1 (ENA), X2.1 (ENA)
/MISO: J1.7, U2.16 (MISO)
/MOSI: J1.6, U2.15 (MOSI), U4.5 (MOSI), U5.5 (MOSI)
/REFIN+/OUT: C3.1, C19.1, C20.1, J1.22, U2.4 (REFIN+/OUT), U4.11 (VREFB), U4.13 (VREFA), U5.11 (VREFB), U5.13 (VREFA)
/SCK: J1.5, U2.14 (SCK), U4.4 (SCK), U5.4 (SCK)
/VREF: C5.1, J1.23, U1.6 (VREF), U3.3
/VREF_BUF: J1.24, U3.1, U3.4
/~ADC_CS: J1.4, U2.13 (~CS)
/~DAC1_CS: J1.1, U5.3 (~CS)
/~DAC2_CS: J1.2, U4.3 (~CS)
/~IRQ/MDAT: J1.8, U2.17 (~IRQ/MDAT)
/~LDAC: J1.3, U4.8 (~LDAC), U5.8 (~LDAC)
GND: C1.2, C2.2, C3.2, C4.2, C5.2, C6.2, C7.2, C8.2, C9.1, C10.2, C11.2, C12.1, C13.2, C14.1, C15.2, C16.1, C17.2, C18.2, C19.2, C20.2, J1.11, J1.13, U1.1 (GND), U1.2 (GND), U2.2 (AGND), U2.3 (REFIN-), U2.19 (DGND), U3.2, U4.12 (VSS), U5.12 (VSS), X1.2 (GND), X2.2 (GND)
unnamed: C9.2, R1.1, U2.5 (CH0)
unnamed: C10.1, R2.1, U2.6 (CH1)
unnamed: C12.2, R4.1, U2.7 (CH2)
unnamed: C11.1, R3.1, U2.8 (CH3)
unnamed: C16.2, R8.1, U2.9 (CH4)
unnamed: C15.1, R7.1, U2.10 (CH5)
unnamed: C14.2, R6.1, U2.11 (CH6)
unnamed: C13.1, R5.1, U2.12 (CH7)

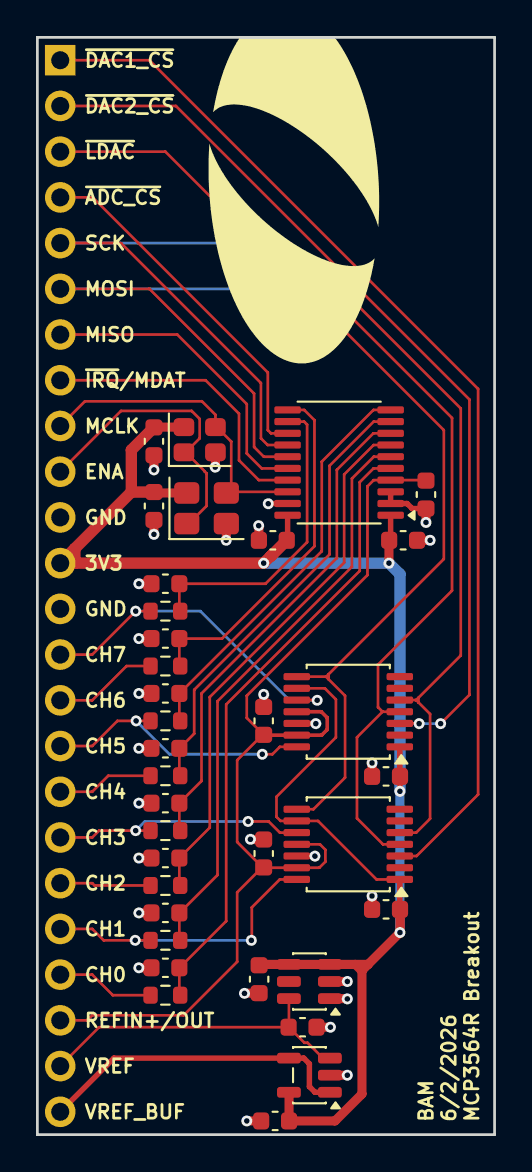
[picture p58: board mcp3564rbreakout.kicad_pcb from above]

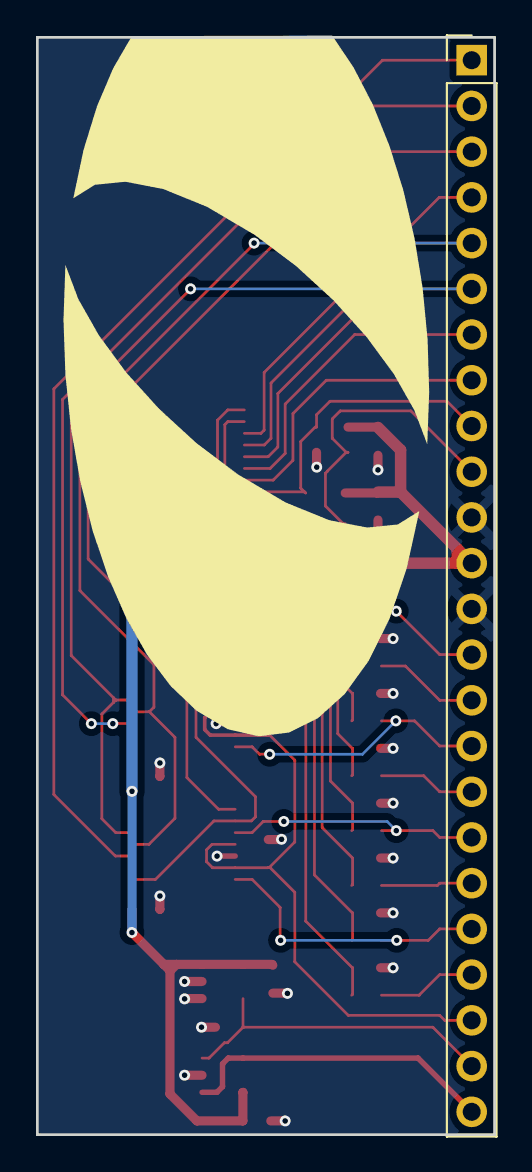
[picture p59: board mcp3564rbreakout.kicad_pcb from below]

Board: 2 copper layers, 25.4 x 61.0 mm, 38 parts (2 on the bottom side), 31 nets.

Other parts of the board:
OlinLogoTruncated: G***; OlinLogoTruncated
svg2mod: G***; OlinLogoTruncated_0.35in
