bminch/me_gizmo/PCBs/screwterminalbreakout/screwterminalbreakout.kicad_pcb

## KiCad design PCBs/screwterminalbreakout/screwterminalbreakout.kicad_pcb (2026-06-01)

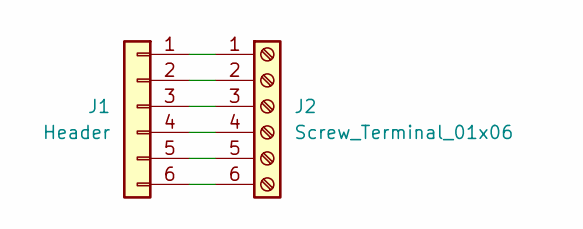
[picture p60: schematic screwterminalbreakout.kicad_sch, Six-pin Screw Terminal Breakout]

Parts:
J1: Header; PinHeader_1x06_P2.54mm_Vertical
J2: Screw_Terminal_01x06; TerminalBlock_Phoenix_MPT-0,5-6-2.54_1x06_P2.54mm_Horizontal

Connections:
unnamed: J1.1, J2.1
unnamed: J1.2, J2.2
unnamed: J1.3, J2.3
unnamed: J1.4, J2.4
unnamed: J1.5, J2.5
unnamed: J1.6, J2.6

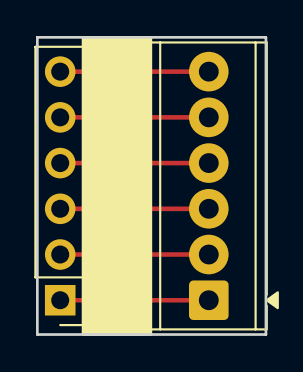
[picture p61: board screwterminalbreakout.kicad_pcb from above]

Board: 2 copper layers, 12.7 x 16.5 mm, 3 parts (1 on the bottom side), 6 nets.

Other parts of the board:
svg2mod: G***; OlinLogoTruncated_0.225in
