bminch/me_gizmo/PCBs/mcp3562rbreakout/mcp3562rbreakout.kicad_pcb

## KiCad design PCBs/mcp3562rbreakout/mcp3562rbreakout.kicad_pcb (2026-06-01)

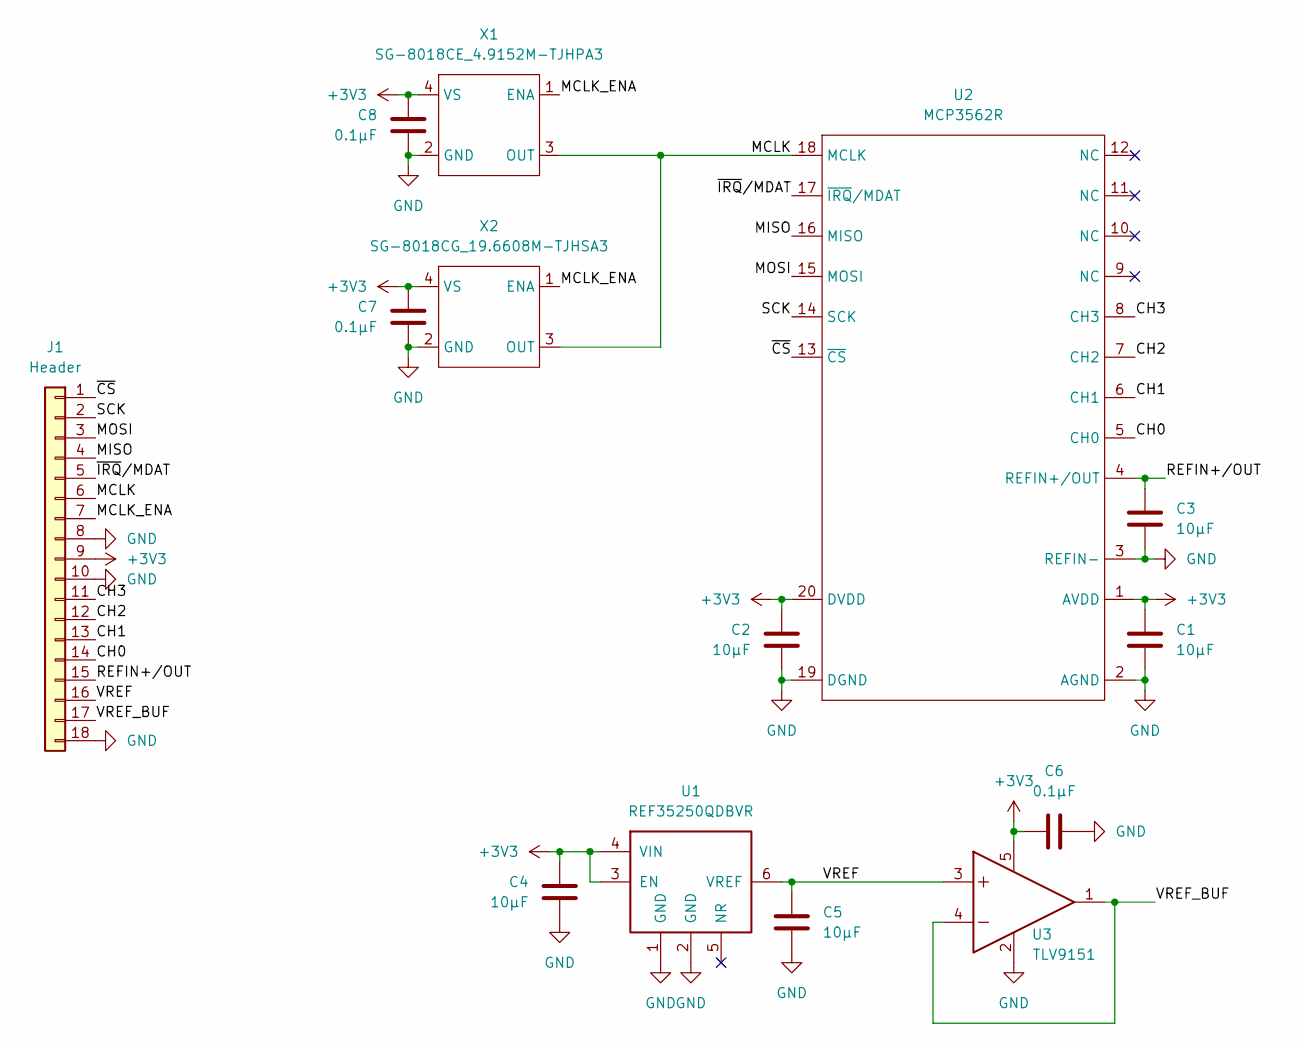
[picture p62: schematic mcp3562rbreakout.kicad_sch, MCP3562R Breakout]

Parts:
C1, C2, C3, C4, C5: 10µF; C_0603_1608Metric
C6, C7, C8: 0.1µF; C_0603_1608Metric
J1: Header; PinHeader_1x18_P2.54mm_Vertical
U1: REF35250QDBVR; SOT-23-6
U2: MCP3562R; TSSOP-20_4.4x6.5mm_P0.65mm
U3: TLV9151; SOT-23-5
X1: SG-8018CE_4.9152M-TJHPA3; Crystal_SMD_3225-4Pin_3.2x2.5mm
X2: SG-8018CG_19.6608M-TJHSA3; Crystal_SMD_2520-4Pin_2.5x2.0mm

Connections:
+3V3: C1.1, C2.1, C4.1, C6.1, C7.1, C8.1, J1.9, U1.3 (EN), U1.4 (VIN), U2.1 (AVDD), U2.20 (DVDD), U3.5, X1.4 (VS), X2.4 (VS)
/CH0: J1.14, U2.5 (CH0)
/CH1: J1.13, U2.6 (CH1)
/CH2: J1.12, U2.7 (CH2)
/CH3: J1.11, U2.8 (CH3)
/MCLK: J1.6, U2.18 (MCLK), X1.3 (OUT), X2.3 (OUT)
/MCLK_ENA: J1.7, X1.1 (ENA), X2.1 (ENA)
/MISO: J1.4, U2.16 (MISO)
/MOSI: J1.3, U2.15 (MOSI)
/REFIN+/OUT: C3.1, J1.15, U2.4 (REFIN+/OUT)
/SCK: J1.2, U2.14 (SCK)
/VREF: C5.1, J1.16, U1.6 (VREF), U3.3
/VREF_BUF: J1.17, U3.1, U3.4
/~CS: J1.1, U2.13 (~CS)
/~IRQ/MDAT: J1.5, U2.17 (~IRQ/MDAT)
GND: C1.2, C2.2, C3.2, C4.2, C5.2, C6.2, C7.2, C8.2, J1.8, J1.10, J1.18, U1.1 (GND), U1.2 (GND), U2.2 (AGND), U2.3 (REFIN-), U2.19 (DGND), U3.2, X1.2 (GND), X2.2 (GND)

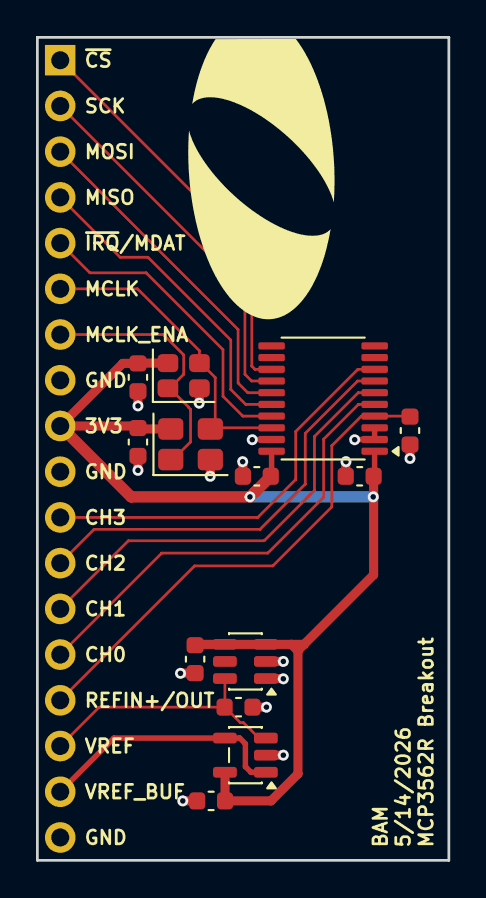
[picture p63: board mcp3562rbreakout.kicad_pcb from above]

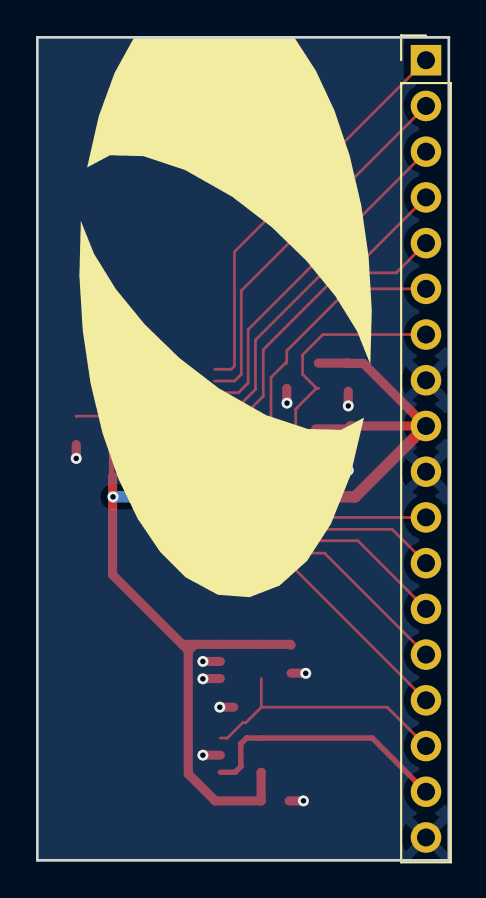
[picture p64: board mcp3562rbreakout.kicad_pcb from below]

Board: 2 copper layers, 22.9 x 45.7 mm, 16 parts (2 on the bottom side), 16 nets.

Other parts of the board:
OlinLogoTruncated_0.6in: G***; OlinLogoTruncated_0.6in
svg2mod: G***; OlinLogoTruncated_0.3in
