bminch/me_gizmo/Firmware/me_gizmo/me_gizmo.h

#ifndef _ME_GIZMO_H_
#define _ME_GIZMO_H_

#include <Arduino.h>
#include <EEPROM.h>
// #include "sram_eeprom.h"
#include <stdint.h>
#include <stdio.h>
#include <stdlib.h>

#ifndef TRUE
#define TRUE                1
#endif

#ifndef FALSE
#define FALSE               0
#endif

#define BUILTIN_LED         11

#define EEPROM_LENGTH       1024

#define DEBUG_TIMING_PIN    26

// MCP3564R analog-to-digital converter (ADC) pin definitions
#define ADC_CSN             17
#define ADC_IRQ_            18
#define ADC_SCK             21
#define ADC_MOSI            22
#define ADC_MISO            24
// #define ADC_IRQ_            20      // Prototype
// #define ADC_SCK             18      // Prototype
// #define ADC_MISO            16      // Prototype
// #define ADC_MOSI            19      // Prototype

// MCP3564R register address definitions (see Table 8-1 on p. 89 of the MCP3561/2/4R datasheet)
#define ADC_ADCDATA         0   // Latest ADC conversion data output value (3 or 4 bytes depending on DATA_FORMAT[1:0])
#define ADC_CONFIG0         1   // ADC operating mode, Master clock mode and input bias current source mode (1 byte)
#define ADC_CONFIG1         2   // Prescale and OSR settings (1 byte)
#define ADC_CONFIG2         3   // ADC boost and gain settings, auto-zeroing settings for analog mux, voltage regerence and ADC (1 byte)
#define ADC_CONFIG3         4   // Conversion mode, data and CRC format settings, enable for CRC on communications, enable for digital offset and gain calibrations (1 byte)
#define ADC_IRQ             5   // IRQ status bits and mode settings, enable for fast commands and for conversion start pulse (1 byte)
#define ADC_MUX             6   // Analog mux input selection (1 byte)
#define ADC_SCAN            7   // SCAN mode settings (3 bytes)
#define ADC_TIMER           8   // Delay value for TIMER between SCAN cycles (3 bytes)
#define ADC_OFFSETCAL       9   // ADC digital offset calibration value (3 bytes)
#define ADC_GAINCAL         10  // ADC digital gain calibration value (3 bytes)
#define ADC_RESERVED1       11  // Reserved (3 bytes)
#define ADC_RESERVED2       12  // Reserved (1 byte)
#define ADC_LOCK            13  // Password value for SPI write mode locking (1 byte)
#define ADC_RESERVED3       14  // Reserved (2 bytes)
#define ADC_CRCCFG          15  // CRC checksum for device configuration (2 bytes)

// MCP3564R fast command definitions (see Table 6-2 on p. 68 of the MCP3561/2/4R datasheet)
#define ADC_START_CONV      10
#define ADC_STANDBY         11
#define ADC_SHUTDOWN        12
#define ADC_FULL_SHUTDOWN   13
#define ADC_FULL_RESET      14

// MCP3564R input multiplexer register values (see Secion 8.7 on p. 96 of the MCP3561/2/4R datasheet)
#define ADC_MUX_VREF        0xB8    // VIN+ = REFIN+/OUT, VIN- = AGND
#define ADC_MUX_NEG_VREF    0x8B    // VIN+ = AGND, VIN- = REFIN+/OUT
#define ADC_MUX_DIFFAB      0x13    // VIN+ = CH1/DACA, VIN- = CH3/DACB
#define ADC_MUX_DIFFCD      0x57    // VIN+ = CH5/DACC, VIN- = CH7/DACD
#define ADC_MUX_CH0_SE      0x08    // VIN+ = CH0, VIN- = AGND
#define ADC_MUX_CH1_SE      0x18    // VIN+ = CH1/DACA, VIN- = AGND
#define ADC_MUX_CH2_SE      0x28    // VIN+ = CH2, VIN- = AGND
#define ADC_MUX_CH3_SE      0x38    // VIN+ = CH3/DACB, VIN- = AGND
#define ADC_MUX_CH4_SE      0x48    // VIN+ = CH4, VIN- = AGND
#define ADC_MUX_CH5_SE      0x58    // VIN+ = CH5/DACC, VIN- = AGND
#define ADC_MUX_CH6_SE      0x68    // VIN+ = CH6, VIN- = AGND
#define ADC_MUX_CH7_SE      0x78    // VIN+ = CH7/DACD, VIN- = AGND
#define ADC_MUX_CHA_DIFF    0x01    // VIN+ = CH0, VIN- = CH1/DACA
#define ADC_MUX_CHB_DIFF    0x23    // VIN+ = CH2, VIN- = CH3/DACB
#define ADC_MUX_CHC_DIFF    0x45    // VIN+ = CH4, VIN- = CH5/DACC
#define ADC_MUX_CHD_DIFF    0x67    // VIN+ = CH6, VIN- = CH7/DACD

// MCP4922 digital-to-analog converter (DAC) pin definitions
// Note: DAC shares SCK and MOSI lines with ADC
#define DAC1_CSN            19
#define DAC2_CSN            20
#define DAC_LDAC            16
// #define DAC1_CSN            21      // Prototype
// #define DAC2_CSN            26      // Prototype
// #define DAC_LDAC            28      // Prototype

// ADG714 switch array pin definitions (shares SCK and MOSI)
#define SW_SYNC             14
#define SW_RESET            15

// TMP126-Q1 temperature sensor pin definitions (shares SCK, MISO, and MOSI)
#define TEMP_CS             25
// #define TEMP_CS             13      // Prototype

// TMP126-Q1 register address definitions, 1 byte each (see Table 8-3 on p. 25 of the TMP126-Q1 datasheet)
#define TEMP_RESULT         0   // Read temperature result
#define SLEW_RESULT         1   // Read slew rate result
#define ALERT_STATUS        2   // Read alert status
#define CONFIGURATION       3   // Read/write device configuration
#define ALERT_ENABLE        4   // Read/write alert enable
#define T_LOW_LIMIT         5   // Read/write temperature low limit
#define T_HIGH_LIMIT        6   // Read/write temperature high limit
#define HYSTERESIS          7   // Read/write hysteresis values for temperature limits
#define SLEW_LIMIT          8   // Read/write slew rate limit
#define UNIQUE_ID1          9   // Read Unique ID1
#define UNIQUE_ID2          10  // Read Unique ID2
#define UNIQUE_ID3          11  // Read Unique ID3
#define DEVICE_ID           12  // Read Device ID
#define RESERVED            13  // Reserved


void init_me_gizmo(void);

void init_adc(void);
uint8_t adc_fast_cmd(uint8_t address, uint8_t command);
uint8_t adc_read_reg_static(uint8_t address, uint8_t reg, uint8_t *buffer, uint8_t num_bytes);
uint8_t adc_read_reg_incremental(uint8_t address, uint8_t reg, uint8_t *buffer, uint8_t num_bytes);
uint8_t adc_write_reg_incremental(uint8_t address, uint8_t reg, uint8_t *buffer, uint8_t num_bytes);
uint8_t adc_get_irq(void);
uint8_t adc_get_azmux(uint8_t address);
void adc_set_azmux(uint8_t address, uint8_t azmux);
uint8_t adc_get_enoffcal(uint8_t address);
void adc_set_enoffcal(uint8_t address, uint8_t enoffcal);
uint8_t adc_get_engaincal(uint8_t address);
void adc_set_engaincal(uint8_t address, uint8_t engaincal);
uint8_t adc_get_osr(uint8_t address);
void adc_set_osr(uint8_t address, uint8_t osr);
uint8_t adc_get_gain(uint8_t address);
void adc_set_gain(uint8_t address, uint8_t gain);
uint32_t adc_read_data(uint8_t address);
uint32_t adc_get_data(uint8_t address);
uint16_t adc_get_scan_list(uint8_t address);
void adc_set_scan_list(uint8_t address, uint16_t value);
uint8_t adc_get_scan_delay(uint8_t address);
void adc_set_scan_delay(uint8_t address, uint8_t value);
uint16_t adc_scan_once(uint8_t address, uint32_t *buffer);

void init_dac_pre_init_adc(void);
void init_dac_post_init_adc(void);
void dac_update_dacA(void);
void dac_update_dacB(void);
void dac_update_dacC(void);
void dac_update_dacD(void);
void dac_load(void);
void dac_dacA_set_val(uint16_t value);
uint16_t dac_dacA_get_val(void);
void dac_dacA_set_ena(uint8_t ena);
uint8_t dac_dacA_get_ena(void);
void dac_dacB_set_val(uint16_t value);
uint16_t dac_dacB_get_val(void);
void dac_dacB_set_ena(uint8_t ena);
uint8_t dac_dacB_get_ena(void);
void dac_dacC_set_val(uint16_t value);
uint16_t dac_dacC_get_val(void);
void dac_dacC_set_ena(uint8_t ena);
uint8_t dac_dacC_get_ena(void);
void dac_dacD_set_val(uint16_t value);
uint16_t dac_dacD_get_val(void);
void dac_dacD_set_ena(uint8_t ena);
uint8_t dac_dacD_get_ena(void);
void dac_diffAB_set_val(int16_t value);
int16_t dac_diffAB_get_val(void);
void dac_diffAB_set_ena(uint8_t ena);
uint8_t dac_diffAB_get_ena(void);
void dac_diffCD_set_val(int16_t value);
int16_t dac_diffCD_get_val(void);
void dac_diffCD_set_ena(uint8_t ena);
uint8_t dac_diffCD_get_ena(void);

void init_sw(void);
uint8_t* sw_get_state(void);
void sw_set_state(uint8_t value[]);
void sw_reset(void);

void init_temp(void);
uint16_t get_temp(void);

#endif
