bminch/me_gizmo/(commit log)

2026-06-04 Created KiCAD conceptual schematic for strain gauge connections
    [me_gizmo.kicad_pcb, me_gizmo.kicad_sch]
2026-06-11 Added MCP3564R breakout board and added supporting firmware / software.
    [397000006.stp, RP2350B.step, RP2354B.step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]
2026-06-15 Fixed bug in calibrate.py where MUX register had been set to MUX_DIFFCD rather than MUX_DIFFAB.
    [calibrate.py]
2026-06-15 Collection script that utilizes the streaming feature for 4-channel ADC and kicad schematic for wheatstone bridge breakout board
    [SO16_SOT109-1_NEX.stl, bridge1.kicad_sch, bridge2.kicad_sch, bridge3.kicad_sch, bridge4.kicad_sch, me_gizmo.kicad_pcb, me_gizmo.kicad_sch]
2026-06-23 Completed ADG714 Breakout kicad (awaiting further review)
    [WB_Breakout.kicad_pcb, WB_Breakout.kicad_sch, bridge2.kicad_sch, bridge3.kicad_sch, bridge4.kicad_sch, me_gizmo.kicad_pcb]
2026-06-24 Updated resistor values in schematic, moved vias off pads, added bypass capacitors
    [WB_Breakout.kicad_pcb, WB_Breakout.kicad_sch]
2026-06-25 Added a BOM for the WB breakout and made a LED indicator breakout board
    [LED_Breakout.kicad_pcb, LED_Breakout.kicad_sch, WB_Breakout.csv, WB_Breakout.kicad_sch]
2026-06-26 Fixed pin header width in WB breakout
    [WB_Breakout.kicad_pcb]
2026-06-29 Added rp2350dev PCB design files.
    [LED_Breakout-B_Cu.gbr, LED_Breakout-B_Mask.gbr, LED_Breakout-B_Paste.gbr, LED_Breakout-B_Silkscreen.gbr, LED_Breakout-Edge_Cuts.gbr, LED_Breakout-F_Cu.gbr, LED_Breakout-F_Mask.gbr, LED_Breakout-F_Paste.gbr]
2026-06-29 Added rp2350dev_rainbow sample Arduino project.
2026-07-02 Functional software and Firmware for sw_array breakout boards (untested spi)
2026-07-16 First draft on the schematic for the final device
    [ADC.kicad_sch, CH1.kicad_sch, CH2.kicad_sch, CH3.kicad_sch, CH4.kicad_sch, DAC.kicad_sch, SO16_SOT109-1_NEX.stl, SWITCHES.kicad_sch]
2026-07-25 Completed first draft of integrated measurement unit
    [ADC.kicad_sch, CH1.kicad_sch, CH2.kicad_sch, CH3.kicad_sch, CH4.kicad_sch, LEDs.kicad_sch, SWITCHES.kicad_sch, me_gizmo.kicad_pcb]
2026-07-27 Second draft of final layout
    [CH3.kicad_sch, me_gizmo.kicad_pcb]
2026-07-28 Made a few final layout tweaks and added a BOM file
    [me_gizmo.kicad_pcb, me_gizmo.kicad_sch, me_gizmo_BOM.csv]
2026-07-28 Switched the DAC connections on channels 3 and 4 to reflect the flipped bridge configurations
    [ADC.kicad_sch, PCB_cover-me_gizmo.dwg, me_gizmo.kicad_pcb]
2026-08-10 Added Main.py with a channel configuration detection script. Also added a thread that updates the leds to display what the device thinks the current operating mode is, particularly while actively loo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
    [ADC.kicad_sch, CH1.kicad_sch, LEDs.kicad_sch, me_gizmo.kicad_pcb, me_gizmo_BOM.csv]
